BuiVanYen/DATN_START/Hardware/Dung dich/A_B/image.png

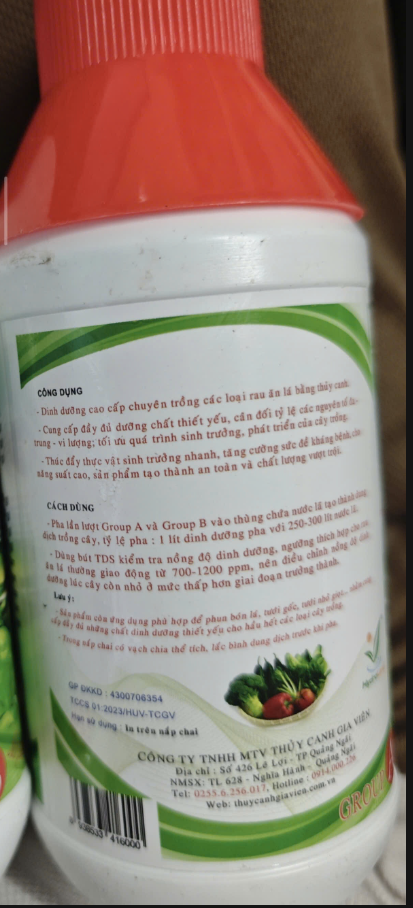
Hardware/Dung dich/A_B/image.png
