BuiVanYen/DATN_START/Hardware/Sensor_use/sht30/image1.png

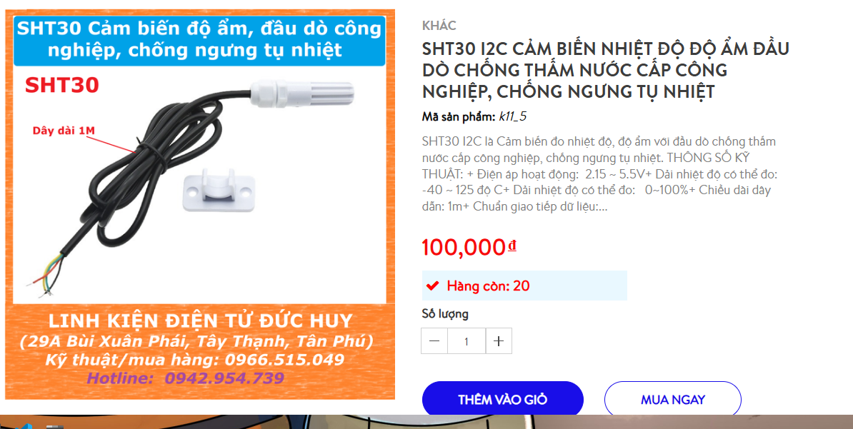
Hardware/Sensor_use/sht30/image1.png
