BuiVanYen/DATN_START/docs/Bao_Cao_Tien_Do/Bao_cao_He_thong_AIoT_Digital_Twin.pptx

BÁO CÁO ĐỒ ÁN TỐT NGHIỆP
ỨNG DỤNG AIoT TRỒNG XÀ LÁCH THỦY CANH NFT
VỚI CÔNG NGHỆ DIGITAL TWIN
Hệ thống giám sát, điều khiển thời gian thực kết hợp AI & Mô phỏng cơ điện tử 3D

Sinh viên thực hiện: [Tên Sinh Viên]
Giáo viên hướng dẫn: [Tên GVHD]
Chuyên ngành: Kỹ thuật Điều khiển & Tự động hóa

## Slide 2

GIỚI THIỆU CHUNG

Tổng Quan Đồ Án & Công Nghệ Lõi

Đồ án xây dựng một giải pháp nông nghiệp công nghệ cao toàn diện, tích hợp trí tuệ nhân tạo và mô phỏng 3D thời gian thực. Hệ thống được chia thành 3 mảng cốt lõi:

1. IoT & Phần Cứng
Trạm giám sát ESP32 thu thập các thông số pH, TDS, nhiệt độ, độ ẩm và mực nước bể.
Điều khiển chính xác cơ cấu chấp hành bằng tín hiệu PWM (quạt gió, bơm dinh dưỡng) và Relay (bơm chính, sục khí, LED Grow).

2. AI & FastAPI Backend
FastAPI làm trung tâm điều phối dữ liệu MQTT, lưu trữ InfluxDB, đồng bộ WebSocket.
Tích hợp mô hình học sâu CNN (MobileNetV2 TFLite) nhận diện bệnh lá và XGBoost Regressor dự báo sinh trưởng.

3. Digital Twin 3D
Mô hình hóa hệ thống 3D trên Siemens NX MCD (Mechatronics Concept Designer).
Đồng bộ hóa 2 chiều thực - ảo qua OPC UA, mô phỏng động học quạt, dòng chảy nước và quá trình lớn lên của cây.

## Slide 3

KIẾN TRÚC HỆ THỐNG

Sơ Đồ Khối Hệ Thống Tổng Thể

**Luồng dữ liệu thu thập & điều khiển:**
1. Trạm ESP32-S3 gửi dữ liệu cảm biến qua MQTT lên FastAPI.
2. FastAPI lưu dữ liệu chuỗi thời gian vào InfluxDB, đồng thời đẩy lên Web UI qua WebSocket.
3. FastAPI cập nhật dữ liệu cảm biến lên OPC UA Server.
4. Mô hình Siemens NX MCD kết nối OPC UA Server để đồng bộ hóa hoạt động ảo.
5. Ngược lại, lệnh điều khiển từ Web UI được FastAPI ghi vào OPC UA Server và gửi về ESP32 điều khiển thực tế.

ESP32-S3
(Cảm biến & Relay)

MQTT Broker
(Mosquitto)

Web UI
(Dashboard)

FastAPI Backend
(Bộ điều phối chính)

InfluxDB
(Time-Series)

OPC UA Server
(asyncua)

AI Modules
(CNN & XGBoost)

Siemens NX MCD
(Mô phỏng 3D)

## Slide 4

PHẦN 1
FASTAPI BACKEND - BỘ NÃO ĐIỀU PHỐI TRUNG TÂM
Xử lý dữ liệu, kiểm soát thiết bị, tích hợp trí tuệ nhân tạo và đồng bộ hóa thực - ảo

## Slide 5

PHẦN 1: FASTAPI BACKEND

FastAPI - Vai Trò Và Các Đầu Mục Công Việc

**1. Thu thập & Quản lý dữ liệu cảm biến:**
Lắng nghe luồng dữ liệu MQTT JSON từ ESP32.
Bóc tách các thông số: Nhiệt độ, độ ẩm, pH, TDS, mực nước.
Ghi đồng thời dữ liệu vào cơ sở dữ liệu chuỗi thời gian InfluxDB.
**2. Cung cấp API Điều khiển Thiết bị:**
Nhận lệnh điều khiển (xung PWM, trạng thái bật/tắt Relay) từ Web UI.
Chuyển tiếp tín hiệu điều khiển xuống ESP32 qua MQTT Broker.

**3. Tích hợp AI trực tiếp trên Backend:**
Endpoint tiếp nhận ảnh tải lên từ Web UI để chạy chẩn đoán bệnh lá (CNN MobileNetV2 - TFLite Interpreter).
Chạy mô hình hồi quy (XGBoost Regressor) định kỳ để dự báo tiến độ sinh trưởng cây.
**4. Đồng bộ hóa thời gian thực (Real-time Link):**
Thiết lập WebSocket Server để đẩy tức thời dữ liệu cảm biến mới lên Web UI.
Kết nối trực tiếp và ghi dữ liệu lên OPC UA Server để đồng bộ hóa trạng thái với mô hình Siemens NX MCD 3D.

## Slide 6

PHẦN 1: FASTAPI BACKEND

Hệ Thống REST API & Kết Nối Đồng Bộ

API Điều khiển Thiết bị (Control)
POST /api/control/pwm: Điều chỉnh tốc độ quạt thông gió (0-255) và 3 bơm châm dinh dưỡng nhu động.
POST /api/control/relay: Bật/tắt bơm chính 220V, máy sục khí oxy bể chứa và 4 cụm đèn LED Grow.

Cơ Chế Đồng Bộ Hóa Dữ Liệu
**Kết nối WebSocket:**
- Tạo kết nối song song, giữ trạng thái liên tục giữa FastAPI và Web UI.
- Cảm biến cập nhật mỗi 30s được đẩy ngay lập tức mà không cần tải lại trang.
**Kết nối OPC UA Bridge:**
- Tích hợp client kết nối vào Python OPC UA Server.
- Tự động đồng bộ các Node: Trạng thái quạt quay, bơm chảy, đèn sáng, mực nước bể sang phần mềm mô phỏng 3D Siemens NX MCD.
- Đảm bảo độ trễ truyền thông < 100ms cho việc giám sát ảo.

API Dữ liệu & AI (Data & AI)
GET /api/sensor-data/latest: Lấy các thông số cảm biến mới nhất.
POST /api/ai/disease-detect: Nhận file ảnh từ camera để suy diễn bệnh.
GET /api/ai/growth-predict: Chạy định kỳ, dự báo % lớn và số ngày thu hoạch.

## Slide 7

PHẦN 2
INFLUXDB TIME-SERIES & GIAO DIỆN WEB UI
Lưu trữ dữ liệu chuỗi thời gian hiệu năng cao và Dashboard giám sát trực quan hóa 2D/AI

## Slide 8

PHẦN 2: CƠ SỞ DỮ LIỆU

Cấu Trúc Cơ Sở Dữ Liệu InfluxDB (Schema Design)

**Tại sao chọn InfluxDB?**
Tối ưu hóa ghi dữ liệu tần suất cao liên tục với mốc thời gian (timestamp).
Hiệu năng vượt trội so với SQL truyền thống đối với ứng dụng giám sát IoT.
Hỗ trợ ngôn ngữ truy vấn Flux mạnh mẽ để tính toán trung bình, lọc nhiễu dữ liệu.

Measurement: sensor_data
Lưu trữ dữ liệu môi trường từ các cảm biến.
**Fields (Dữ liệu số):**
- air_temp (nhiệt độ khí)
- air_humidity (độ ẩm khí)
- water_temp (nhiệt độ nước)
- tds (nồng độ dinh dưỡng)
- ph (độ kiềm/axit)
- light_intensity (cường độ sáng)
**Tags (Chỉ mục tìm kiếm):**
- device_id="esp32_01"
- location="nft_rack_1"

Measurement: actuator_status
Ghi lịch sử bật/tắt thiết bị để giám sát điện năng và vận hành.
**Fields (Số/Logic):**
- fan_1..4_pwm (tốc độ quạt)
- pump_dd_1..2_pwm (bơm dinh dưỡng)
- pump_220v (trạng thái bơm chính)
- grow_light_1..4 (trạng thái LED)
**Tags:**
- device_id="esp32_01"

Measurement: ai_predictions
Lưu vết lịch sử phân tích và suy diễn từ các thuật toán AI.
**Fields (Chuỗi/Số):**
- disease_label (tên loại bệnh)
- confidence (độ tin cậy %)
- growth_percent (% lớn của rau)
- days_remaining (ngày thu hoạch dự kiến)
**Tags:**
- model_version="v1.0"

## Slide 9

PHẦN 2: CƠ SỞ DỮ LIỆU

Vận Hành & Tối Ưu Hóa Dữ Liệu InfluxDB

**1. Cơ chế ghi dữ liệu bất đồng bộ (Async Data Ingestion):**
Trạm ESP32-S3 gửi gói tin JSON lên MQTT Broker mỗi 30 giây.
FastAPI Backend đón nhận bản tin, đóng gói thành đối tượng Point và sử dụng thư viện `influxdb-client-python` ghi bất đồng bộ (async write) vào InfluxDB.
Việc ghi bất đồng bộ giúp API chính không bị nghẽn (non-blocking) khi có nhiều kết nối đồng thời.
**2. Tính ổn định và khả năng phục hồi (High Availability & Reliability):**
Trên Raspberry Pi 4, InfluxDB được cấu hình hoạt động như một **Systemd Service** khởi động cùng hệ điều hành.
Thiết lập chính sách ghi đệm trên RAM và tự động khôi phục dữ liệu khi mất nguồn đột ngột, đảm bảo tính toàn vẹn dữ liệu lịch sử.
**3. Tối ưu hóa lưu trữ (Retention Policies):**
Do Raspberry Pi 4 sử dụng thẻ nhớ dung lượng giới hạn, InfluxDB được cấu hình **Retention Policy** tự động xóa dữ liệu thô cũ sau 30 ngày.
Trước khi xóa, dữ liệu được gom cụm (Downsampling) tính trung bình theo giờ để lưu trữ dài hạn hơn, tránh làm đầy bộ nhớ thẻ nhớ.

## Slide 10

PHẦN 2: WEB UI DASHBOARD

Giao Diện Web UI Dashboard & Điều Khiển Thiết Bị

**Bảng điều khiển trung tâm (Dashboard):**
Hiển thị trực quan các chỉ số cảm biến theo thời gian thực (nhiệt độ, độ ẩm, pH, TDS).
Trạng thái thiết bị hiển thị trực quan thông qua các màu sắc và hiệu ứng chỉ báo động.
**Cơ chế điều khiển thiết bị ngoại vi:**
**Thanh trượt (Slider):** Điều khiển xung PWM từ 0 đến 255 để tăng giảm tốc độ quạt thông gió và lưu lượng bơm châm dinh dưỡng.
**Nút gạt (Toggle Switch):** Điều khiển rơ-le bật/tắt bơm tuần hoàn chính, sục khí, và đèn LED Grow.
Mỗi thao tác của người dùng sẽ kích hoạt ngay một request POST tới endpoint điều khiển tương ứng trên FastAPI.

**Tích hợp biểu đồ phân tích lịch sử (Chart.js):**
Nhúng thư viện biểu đồ JavaScript gọn nhẹ `Chart.js`.
Cho phép người dùng theo dõi biểu đồ đường diễn biến thông số pH, TDS, và nhiệt độ bể chứa trong 24 giờ qua hoặc theo tuần.
Giúp phát hiện sớm sự biến động bất thường của dinh dưỡng để can thiệp kịp thời.
**Đồng bộ giao diện thời gian thực:**
Web UI duy trì kết nối WebSocket liên tục tới FastAPI.
Dữ liệu cảm biến mới tự động cập nhật lên giao diện mà không cần người dùng tải lại trang (F5), mang lại trải nghiệm mượt mà.

## Slide 11

PHẦN 2: WEB UI DASHBOARD

Mô Phỏng 2D & Chẩn Đoán Bệnh Lá Qua Camera

**Mô phỏng Digital Twin dạng 2D trực quan:**
Sử dụng đồ họa Canvas/SVG động để phác họa sơ đồ giàn NFT.
**Cơ chế hoạt động động (Dynamic UI animation):**
- Khi quạt thông gió được bật ở thực tế (hoặc mô phỏng), hình ảnh cánh quạt tương ứng trên Web UI sẽ xoay với tốc độ tỷ lệ thuận.
- Khi máy bơm chính hoạt động, đường dẫn ống nước ảo trên màn hình sẽ tạo hiệu ứng dòng hạt chảy chuyển động.
- Đèn LED Grow chuyển từ xám tối sang màu sáng hồng khi ở trạng thái hoạt động.
Giúp người vận hành nhanh chóng nhận biết trạng thái vật lý của hệ thống chỉ với một cái nhìn lướt qua.

**Tích hợp Camera điện thoại để chẩn đoán bệnh:**
Web UI tận dụng thuộc tính HTML5 `capture="camera"` trong thẻ tải ảnh.
Khi người vận hành mở giao diện trên điện thoại và bấm "Chụp ảnh lá", trình duyệt sẽ tự động kích hoạt camera điện thoại để chụp cận cảnh chiếc lá nghi bị bệnh.
Ảnh chụp được đóng gói dạng `Multipart/form-data` và gửi lên API của FastAPI.
Kết quả chẩn đoán bệnh và độ tin cậy (%) từ mô hình AI được trả về và hiển thị ngay lập tức lên màn hình, đồng thời lưu lịch sử.

## Slide 12

PHẦN 3
OPC UA SERVER - CẦU NỐI ĐỒNG BỘ THỜI GIAN THỰC
Giao thức truyền thông công nghiệp kết nối logic điều khiển với mô hình cơ điện tử 3D

## Slide 13

PHẦN 3: OPC UA SERVER

Nguyên Lý Hoạt Động & Vai Trò Của OPC UA Server

**Tổng quan về giao thức OPC UA:**
Là tiêu chuẩn truyền thông công nghiệp thế hệ mới, độc lập hệ điều hành, bảo mật và tin cậy cao.
Đóng vai trò là "bộ nhớ chia sẻ" hay ngôn ngữ chung kết nối giữa hệ thống phần mềm (FastAPI, Web) và phần phần mềm mô phỏng (Siemens NX MCD).
**Nguyên lý hoạt động Client - Server:**
**OPC UA Server (Trung tâm):** Được triển khai bằng thư viện Python `asyncua` chạy trên Pi hoặc PC giả lập, lắng nghe tại cổng `4840`.
Tạo ra một không gian địa chỉ (Address Space) phân tầng chứa các điểm dữ liệu đại diện cho cảm biến và cơ cấu chấp hành.

**Các Client kết nối tương tác:**
**FastAPI (Client 1):** Khi nhận dữ liệu cảm biến mới từ thực tế, FastAPI ghi giá trị vào các Node cảm biến trên OPC UA Server. Khi nhận lệnh từ Web UI, FastAPI ghi vào các Node thiết bị.
**Siemens NX MCD (Client 2):** Kết nối vào OPC UA Server, liên tục đọc trạng thái các Node thiết bị (quạt, bơm) để kích hoạt chuyển động cơ điện tử 3D tương ứng.
**Python Simulator (Client 3 - Chế độ SIL):** Đọc lệnh điều khiển, mô phỏng phản hồi vật lý (ví dụ: bật quạt làm giảm nhiệt độ ảo), ghi ngược thông số ảo vào các Node cảm biến.

## Slide 14

PHẦN 3: OPC UA SERVER

Sơ Đồ Luồng Truyền Thông Software-in-the-Loop

**Luồng trao đổi tín hiệu hai chiều (Real-time Sync):**
Giao diện Web UI gửi lệnh điều khiển -> FastAPI nhận lệnh -> Ghi lệnh vào OPC UA Server.
Siemens NX MCD 3D liên tục đọc lệnh từ OPC UA Server -> Chạy hoạt cảnh chuyển động 3D tương ứng.
Cảm biến ảo trong NX MCD (ví dụ va chạm nước đầy) -> Ghi True vào Node cảm biến trên OPC UA Server.
FastAPI Backend nhận thay đổi từ OPC UA Server -> Đẩy tin nhắn WebSocket báo đèn đỏ lên Web UI.

Web App
(Giao diện điều khiển)

FastAPI Backend
(Điều hướng tín hiệu)

OPC UA Server
(asyncua - Port 4840)

Siemens NX MCD
(Mô phỏng 3D)

**[Chiều 1: Điều khiển]** Web UI (PWM/Relay) ----> FastAPI ----> OPC UA Node ----> NX MCD (Hoạt cảnh khớp quay/đèn sáng)
**[Chiều 2: Phản hồi cảm biến]** NX MCD (Va chạm nước/Scale cây) ----> OPC UA Node ----> FastAPI ----> Web UI (Đèn báo động/Biểu đồ)

## Slide 15

PHẦN 3: OPC UA SERVER

Chi Tiết Thiết Kế Cấu Trúc Nodes Trên Server

Để các Client thực và ảo hiểu nhau, không gian địa chỉ trên OPC UA Server được quy hoạch đồng nhất bằng các Node ID có cấu trúc rõ ràng:

Thư mục: Cảm biến (Sensors)
Lưu trữ dữ liệu đo lường môi trường từ ESP32 hoặc bộ Simulator.
**Các Node ID chính:**
- `ns=2;s=sensor.temp` (Float)
*Nhiệt độ không khí ảo*
- `ns=2;s=sensor.ph` (Float)
*Độ pH nước bể chứa*
- `ns=2;s=sensor.water_level_1..4`
(Boolean)
*Trạng thái 4 mức nước ảo*

Thư mục: Thiết bị (Actuators)
Chứa trạng thái hoạt động và công suất điều khiển thiết bị.
**Các Node ID chính:**
- `ns=2;s=actuator.fan_1..4` (Int)
*Tốc độ quạt gió (0-255)*
- `ns=2;s=actuator.pump_dd_1..2` (Int)
*Bơm dinh dưỡng PWM*
- `ns=2;s=actuator.pump_220v` (Boolean)
*Trạng thái bơm chính*
- `ns=2;s=actuator.grow_light_1..4`
(Boolean)
*Trạng thái bật/tắt LED*

Thư mục: AI (Predictions)
Lưu trữ kết quả dự báo sinh trưởng của cây từ mô hình XGBoost.
**Các Node ID chính:**
- `ns=2;s=ai.growth_percent` (Float)
*Tiến trình sinh trưởng (0.0% - 100.0%)*
- `ns=2;s=ai.days_remaining` (Float)
*Số ngày dự kiến đến kỳ thu hoạch*
- Các Node này được sử dụng để điều khiển tham số Scale cây trong NX MCD.

## Slide 16

PHẦN 4
TRÍ TUỆ NHÂN TẠO - CNN & XGBOOST
Mô hình học sâu chẩn đoán bệnh lá CNN MobileNetV2 và thuật toán XGBoost dự báo sinh trưởng cây

## Slide 17

PHẦN 4: TRÍ TUỆ NHÂN TẠO

Mô Hình Học Sâu CNN Chẩn Đoán Bệnh Lá

**Tổng quan mô hình CNN MobileNetV2:**
MobileNetV2 là kiến trúc mạng nơ-ron tích chập được cải tiến của Google, thiết kế tối ưu cho thiết bị nhúng nhờ cơ chế tích chập tách kênh chiều sâu (Depthwise Separable Convolution).
Giúp giảm thiểu tối đa số lượng tham số tính toán và dung lượng mô hình, duy trì độ chính xác cao.
**Quy trình chuẩn bị và huấn luyện (Google Colab):**
**Thu thập Dataset:** Xây dựng tập ảnh mẫu khoảng 500-1000 ảnh cho mỗi lớp bệnh gồm: *Healthy* (Lá khỏe), *Leaf Spot* (Đốm lá), *Downy Mildew* (Sương mai), và *Nutrient Deficiency* (Thiếu dinh dưỡng).
**Huấn luyện (Transfer Learning):** Sử dụng Base Model MobileNetV2 đã huấn luyện sẵn trên tập ImageNet, đóng băng các lớp đầu và huấn luyện lại lớp phân loại cuối (Fine-tuning) bằng Keras/TensorFlow.

**Tối ưu hóa và chuyển đổi sang TensorFlow Lite:**
Mô hình ban đầu sau huấn luyện có kích thước rất lớn (~50MB - 100MB), gây quá tải và trễ lớn khi chạy trực tiếp trên CPU của Raspberry Pi 4.
Sử dụng công cụ `TFLiteConverter` để thực hiện lượng tử hóa (Quantization) mô hình từ dạng số thực dấu phẩy động 32-bit sang số nguyên 8-bit (INT8).
Kích thước mô hình giảm xuống **dưới 10MB**, tăng tốc độ suy diễn (inference) lên nhiều lần mà sai lệch độ chính xác không đáng kể.
**Triển khai trên FastAPI:**
Viết module Python nạp trực tiếp file `.tflite` bằng thư viện `tf.lite.Interpreter`.
Thực hiện chẩn đoán bất đồng bộ khi nhận ảnh tải lên từ Web UI.

## Slide 18

PHẦN 4: TRÍ TUỆ NHÂN TẠO

Luồng Xử Lý Suy Diễn Ảnh Của CNN TFLite

**Luồng xử lý từ ảnh chụp camera đến kết quả chẩn đoán:**
1. Người vận hành chụp ảnh lá bệnh bằng điện thoại -> Tải lên qua Web UI gửi tới API `/api/ai/disease-detect`.
2. Bộ tiền xử lý (Preprocessing) trên FastAPI chuyển đổi ảnh về định dạng ma trận $224 \times 224 \times 3$, chuẩn hóa giá trị pixel về đoạn $[0, 1]$ hoặc $[-1, 1]$.
3. Ma trận ảnh được đưa vào `tf.lite.Interpreter` để chạy suy diễn mạng nơ-ron.
4. Lớp Softmax cuối cùng phân loại và trả ra xác suất tin cậy của các loại bệnh tương ứng.
5. Trả về kết quả dạng JSON lên Web UI để hiển thị cho người dùng, đồng thời lưu lịch sử chẩn đoán vào InfluxDB.

Camera Điện Thoại
(Chụp lá bệnh)

Tiền Xử Lý Ảnh
(Resize 224x224)

TFLite Interpreter
(Chạy suy diễn CNN)

Phân Loại Bệnh
(Lớp Softmax)

Kết Quả JSON
(Hiển thị & Lưu)

**[Dữ liệu đầu ra JSON mẫu]**:
`{"status": "success", "disease": "Leaf Spot", "confidence": 94.2, "timestamp": "2026-06-12T15:56:00Z"}`

## Slide 19

PHẦN 4: TRÍ TUỆ NHÂN TẠO

Mô Hình XGBoost Dự Báo Sinh Trưởng & Ngày Thu Hoạch

**Giới thiệu thuật toán XGBoost (Extreme Gradient Boosting):**
Là thuật toán học máy nâng cao dựa trên cấu trúc cây quyết định (Decision Trees), sử dụng kỹ thuật học tăng cường gradient để tối ưu hóa sai số và tốc độ tính toán.
Được áp dụng dưới dạng mô hình hồi quy (Regression) để dự báo phần trăm sinh trưởng (`growth_percent`) và số ngày còn lại đến kỳ thu hoạch (`days_remaining`).
**Nguyên lý sửa sai bằng Gradient (Gradient Boosting):**
Không tạo một cây quyết định đơn lẻ phức tạp dễ bị quá khớp (overfitting).
Xây dựng tuần tự chuỗi các cây quyết định đơn giản (weak learners). Cây thứ hai được huấn luyện để sửa sai số (residuals) của cây thứ nhất, cây thứ ba sửa sai cho cây thứ hai, cứ thế tiếp diễn.
Kết quả dự báo cuối cùng là tổng cộng dồn dự đoán từ tất cả các cây quyết định nhân với hệ số học tập (Learning Rate).

**Các biến đầu vào (Features) của mô hình:**
`cumulative_days` (Tuổi cây): Số ngày kể từ khi trồng lên máng NFT.
`mean_temp` (Nhiệt độ trung bình): Nhiệt độ không khí trung bình trong ngày.
`daily_light_integral` (DLI - Tích lũy ánh sáng): Tổng lượng ánh sáng tích lũy mà cây nhận được mỗi ngày (đo từ cảm biến BH1750).
`average_tds` (TDS trung bình): Nồng độ chất dinh dưỡng trung bình trong nước bể chứa.
`average_ph` (pH trung bình): Chỉ số pH trung bình của nước.
**Các biến đầu ra (Targets):**
`growth_percent` (0.0% đến 100.0%): Tiến độ lớn lên của cây.
`days_remaining` (ví dụ từ 30 ngày đếm ước về 0): Ước tính số ngày còn lại đến thời điểm thu hoạch tối ưu.

## Slide 20

PHẦN 4: TRÍ TUỆ NHÂN TẠO

Vận Hành Dự Báo & Đồng Bộ Kích Thước Cây 3D

**Chu kỳ vận hành của mô hình XGBoost trong hệ thống:**
1. Hằng ngày, FastAPI tự động truy xuất dữ liệu lịch sử tích lũy từ InfluxDB và trích xuất các đặc trưng đầu vào (DLI, TDS trung bình, pH trung bình, nhiệt độ).
2. FastAPI gọi mô hình XGBoost Regressor đã được đóng gói để thực hiện dự báo.
3. Kết quả dự báo được ghi trực tiếp vào các Node tương ứng trên OPC UA Server: `ai.growth_percent` và `ai.days_remaining`.
4. Phần mềm Siemens NX MCD 3D liên tục đọc Node `ai.growth_percent` và gắn trực tiếp giá trị này vào tham số tỷ lệ hình học (**Scale Factor**) của cụm lettuce 3D.
5. Nhờ đó, mô hình cây 3D trên màn hình máy tính tự động phóng to dần từ 0% đến 100% tương thích với sự phát triển thực tế của cây rau.

Dữ Liệu InfluxDB
(Thông số môi trường)

Trích Xuất Đặc Trưng
(Tính DLI, pH, TDS)

Mô Hình XGBoost
(Dự báo sinh trưởng)

Node OPC UA
(ai.growth_percent)

Siemens NX MCD
(Scale cây 3D)

**[Lợi ích của phương pháp này]**:
Trực quan hóa tiến trình sinh trưởng được hỗ trợ bởi trí tuệ nhân tạo một cách sinh động.
Cho phép người vận hành nhìn thấy trước kết quả phát triển ảo trước khi đưa ra quyết định thu hoạch thực tế.

## Slide 21

PHẦN 5
DIGITAL TWIN 3D - SIEMENS NX MCD
Mô phỏng động học cơ điện tử, tương tác vật lý dòng chảy chất lỏng và cảm biến tiệm cận ảo

## Slide 22

PHẦN 5: DIGITAL TWIN 3D

Mô Hình Hóa Bản Sao Số Trên Siemens NX MCD

**Tổng quan về Siemens NX MCD:**
Mechatronics Concept Designer (MCD) cung cấp môi trường mô phỏng vật lý đa ngành (cơ khí, điện, điều khiển).
Cho phép biến các mô hình 3D tĩnh (CAD) thành các đối tượng có tính chất vật lý thực tế, có khớp chuyển động, trọng lực và tương tác va chạm.
**Quy trình xây dựng mô hình ảo:**
**Thiết kế CAD 3D:** Thiết kế mô hình tỷ lệ hình học 1:1 của khung thép giàn thủy canh, máng NFT, bể chứa dung dịch dinh dưỡng, quạt thông gió, phao cơ học, đèn LED Grow và cây xà lách.
**MCD Physics Configuration:** Khai báo các đối tượng cứng (Rigid Body) để gán khối lượng, trọng lực, ma sát cho quạt, máng, phao.

**Thiết lập các khớp động học (Joints & Motion):**
Gán khớp xoay (Hinged Joint) cho các cánh quạt thông gió.
Gán khớp tịnh tiến dọc (Prismatic Joint) cho phao đo mực nước trong bể chứa.
**Kết nối truyền thông (External Signal Configuration):**
Định cấu hình kết nối OPC UA Client tích hợp trong NX MCD.
Thực hiện ánh xạ tín hiệu (Signal Mapping): Liên kết các tham số điều khiển ảo (khớp quay, khớp tịnh tiến, tính chất vật liệu) với các Node ID tương ứng trên OPC UA Server.
Chạy mô hình ở chế độ kiểm thử vòng lặp phần mềm (Software-in-the-Loop - SIL) để kiểm tra tính đúng đắn của giải thuật điều khiển trước khi đấu nối phần cứng thật.

## Slide 23

PHẦN 5: DIGITAL TWIN 3D

Mô Phỏng Cơ Cấu Chấp Hành Ảo Trong NX MCD

**1. Mô phỏng động học quạt thông gió:**
Khớp xoay (Hinged Joint) của cánh quạt được gán cơ chế điều khiển tốc độ (Speed Control).
Khi nhận giá trị xung PWM (0-255) từ Node ID tương ứng qua OPC UA, hệ thống sẽ nhân với hệ số quy đổi để gán vận tốc quay ảo (vòng/phút).
Người vận hành quan sát thấy cánh quạt 3D quay nhanh, chậm tương ứng với thao tác kéo thanh trượt trên Web UI.
**2. Mô phỏng ánh sáng đèn LED Grow:**
Gán thuộc tính vật liệu phát quang (Emission/Luminance) cho các cụm đèn LED Grow 3D.
Khi nhận tín hiệu Relay ON (True) từ OPC UA Server, vật liệu của đèn tự động thay đổi từ màu xám tối sang màu sáng hồng/đỏ rực rỡ, biểu thị đèn đang hoạt động chiếu sáng bổ sung quang phổ cho cây rau.

**3. Mô phỏng máy bơm & dòng chảy dinh dưỡng:**
Sử dụng tính năng tạo hạt vật lý (Liquid/Particle Path) trong NX MCD để giả lập dòng nước chảy.
Khi bơm tuần hoàn chính ở trạng thái ON, vòi cấp nước sẽ phun ra liên tục các hạt chất lỏng ảo chịu tác động của trọng lực.
Các hạt nước ảo tự động chảy dọc theo độ dốc của máng NFT, bao quanh rễ cây ảo và chảy dồn về ống thoát để rơi ngược lại bể chứa.
Lưu lượng nước ảo phun ra (tần suất sinh hạt) được lập trình tỷ lệ thuận với xung điều khiển PWM của bơm châm dinh dưỡng nhận từ OPC UA Server.

## Slide 24

PHẦN 5: DIGITAL TWIN 3D

Mô Phỏng Mực Nước & Cảm Biến Tiệm Cận Ảo

**Mô phỏng cơ chế phao đo nước cơ học:**
Một phao nhựa 3D được thiết kế đặt trong bể chứa dung dịch dinh dưỡng.
Phao được gán khớp tịnh tiến đứng (Prismatic Joint) và có lực đẩy nổi ảo khi các hạt chất lỏng dâng lên.
Khi mức nước (hạt chất lỏng) dâng cao, phao cơ học tự động trượt lên trên dọc theo trục Prismatic Joint.
**Mô phỏng cảm biến tiệm cận ảo (Giả lập cảm biến Y26):**
Đặt 4 cảm biến va chạm ảo (Collision Sensor) tương ứng với 4 cao độ nước đầy/cạn khác nhau trong bể chứa ảo.
Các cảm biến va chạm này hoạt động bằng cách phát hiện sự giao thoa không gian hình học (Collision) với phao nhựa ảo hoặc với các hạt chất lỏng dâng lên.

**Cơ chế truyền tín hiệu phản hồi ngược:**
Khi phao nhựa ảo dâng lên và chạm vào Collision Sensor thứ 4 (mốc nước đầy):
- 1. Collision Sensor 3D kích hoạt trạng thái logic True.
- 2. NX MCD ngay lập tức ghi giá trị True vào Node ID `ns=2;s=sensor.water_level_4` trên OPC UA Server.
- 3. FastAPI Backend đang lắng nghe OPC UA Server phát hiện sự thay đổi này.
- 4. FastAPI bóc tách dữ liệu và đẩy bản tin qua WebSocket tới Web UI.
- 5. Web UI lập tức nhấp nháy đèn cảnh báo đỏ và hiển thị trạng thái "Bể nước đầy" trên Dashboard.
Thể hiện sự khép kín của vòng lặp điều khiển và giám sát thực - ảo hai chiều.

## Slide 25

TỔNG KẾT

Kết Luận & Hướng Phát Triển Đề Tài

**Các kết quả đạt được của đồ án:**
**Thiết kế hệ thống SIL (Software-in-the-Loop) hoàn chỉnh:** Cho phép thử nghiệm, tối ưu hóa các thuật toán điều khiển và chẩn đoán AI mà không cần lắp đặt phần cứng thực tế, giảm thiểu rủi ro hỏng hóc và chi phí thử nghiệm.
**Hệ thống Backend & Database mạnh mẽ:** FastAPI điều phối dữ liệu với độ trễ thấp (< 100ms), InfluxDB lưu trữ dữ liệu chuỗi thời gian tối ưu hóa dung lượng thẻ nhớ cho Pi.
**Tích hợp mô hình AI thực tế:** CNN MobileNetV2 lượng tử hóa chạy mượt mà dưới 10MB trên Pi cho kết quả chẩn đoán nhanh. XGBoost dự báo chính xác ngày thu hoạch.
**Bản sao số 3D sinh động:** Siemens NX MCD mô phỏng chân thực động học, chất lỏng và scale kích thước cây theo AI.

**Hướng phát triển tiếp theo:**
**Đấu nối phần cứng thật (Hardware-in-the-Loop - HIL):** Thiết lập và chế tạo mạch PCB ESP32-S3 thực tế để thu thập dữ liệu cảm biến thực và điều khiển các thiết bị thật (quạt, bơm, LED thật).
**Hiệu chuẩn mô hình AI (Calibration):** Tiếp tục thu thập thêm ảnh lá bệnh thực tế tại vườn để tăng cường độ chính xác cho mô hình CNN. Thu thập dữ liệu thực tế nhiều vụ trồng xà lách để hiệu chỉnh mô hình XGBoost.
**Mở rộng mô phỏng vật lý:** Mô phỏng nâng cao ảnh hưởng của lưu lượng gió từ quạt đến sự giảm nhiệt độ và độ ẩm ảo trong NX MCD bằng cách kết hợp giải thuật CFD (Computational Fluid Dynamics) đơn giản hóa.
