BuiVanYen/DATN_START/Hardware/BanVeCK_Yen/machcontrol.jpg

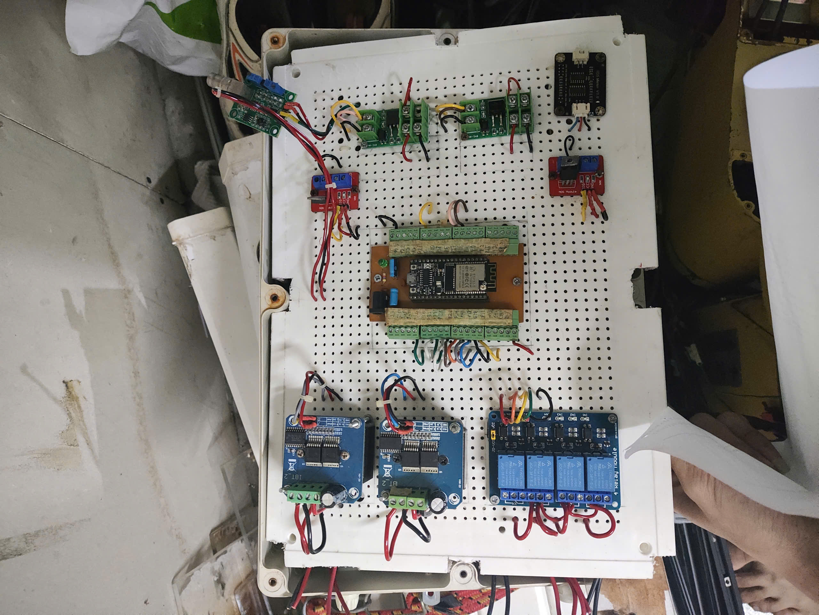
Hardware/BanVeCK_Yen/machcontrol.jpg
