BuiVanYen/DATN_START/Hardware/BanVeCK_Yen/mau.jpg

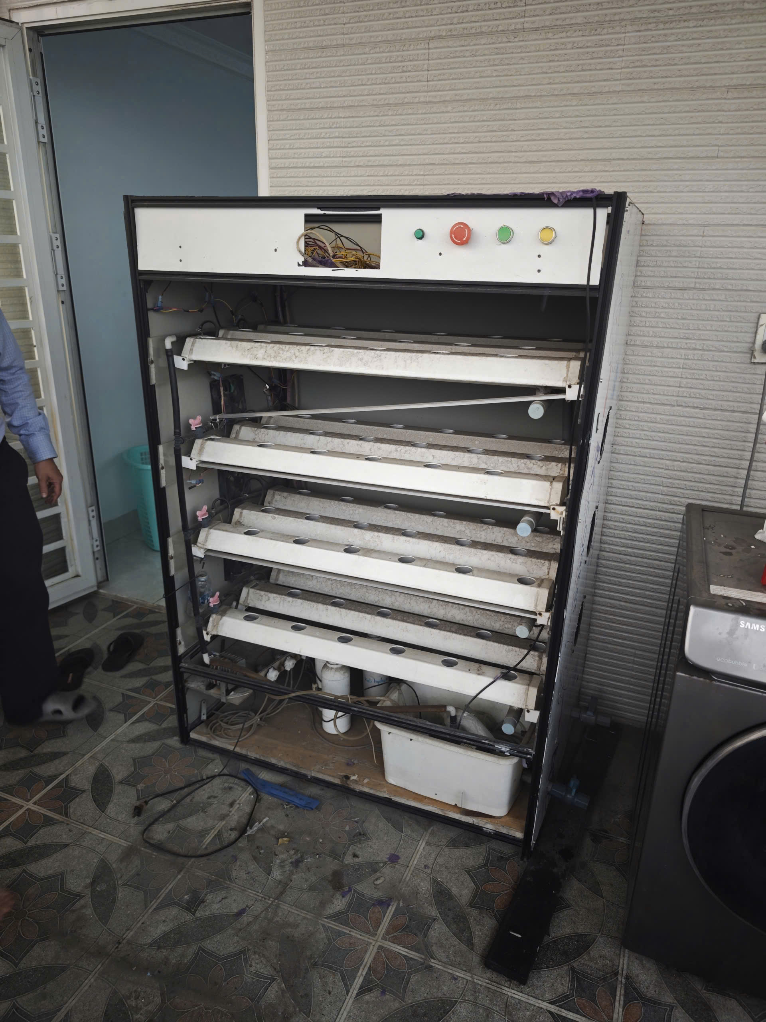
Hardware/BanVeCK_Yen/mau.jpg
