BuiVanYen/DATN_START/Hardware/Dung dich/A_B/image1.png

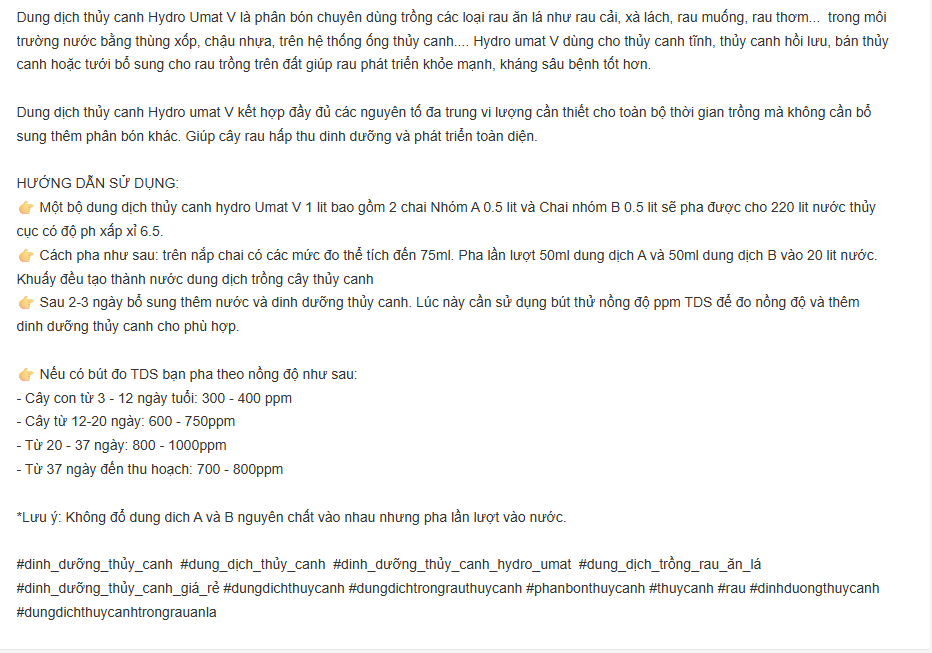
Hardware/Dung dich/A_B/image1.png
