BuiVanYen/DATN_START/Hardware/Dung dich/Ph down/image.png

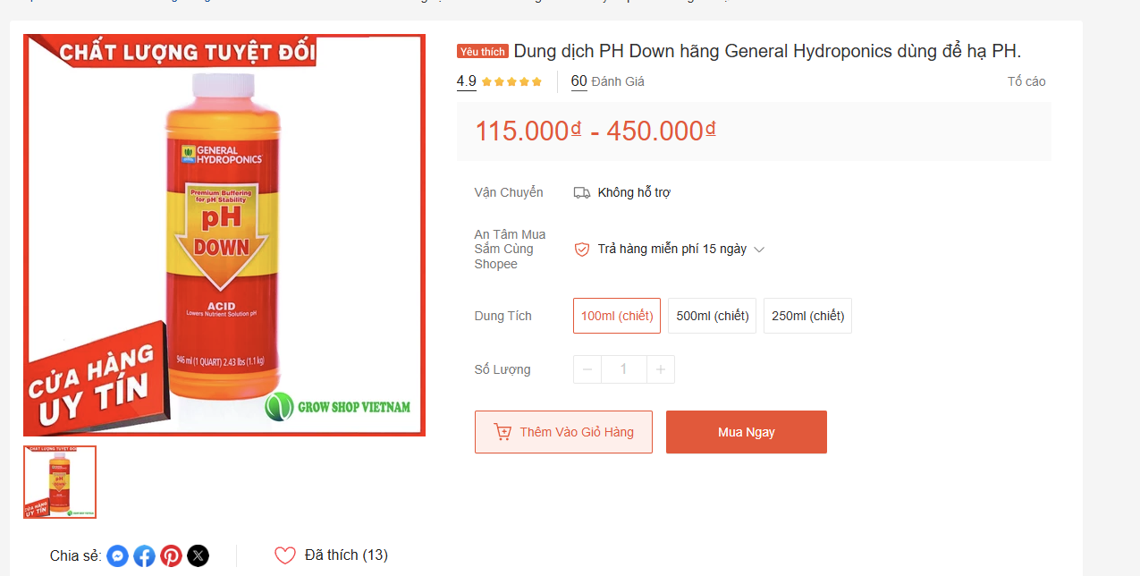
Hardware/Dung dich/Ph down/image.png
