BuiVanYen/DATN_START/Hardware/PCB_Design/schematic_ver2_page1.png

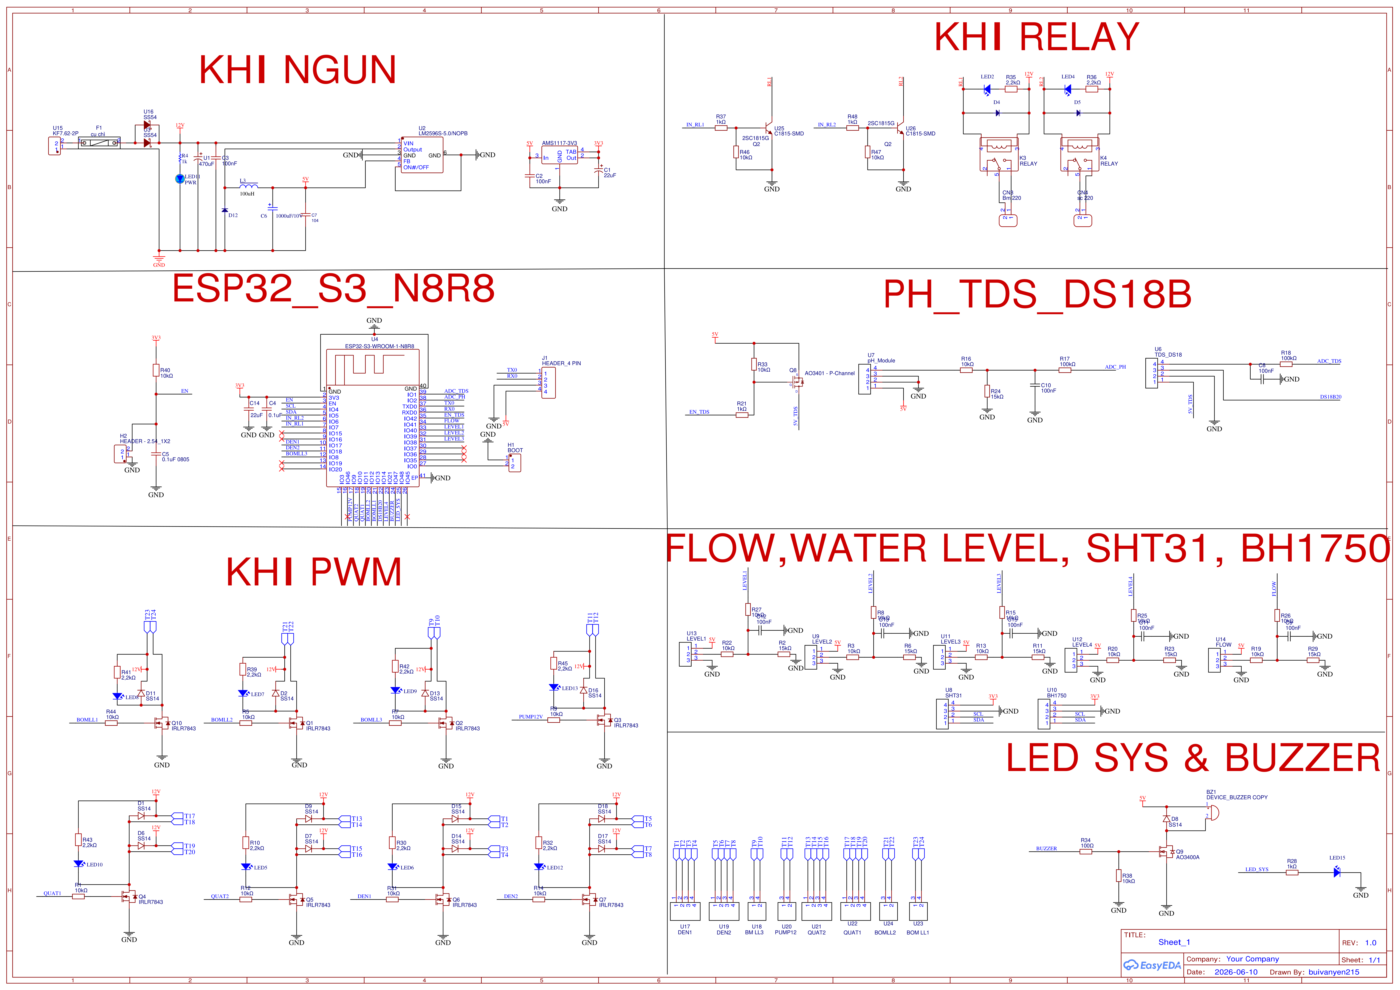
Hardware/PCB_Design/schematic_ver2_page1.png
