BuiVanYen/DATN_START/Hardware/Sensor_use/bh1750/image.png

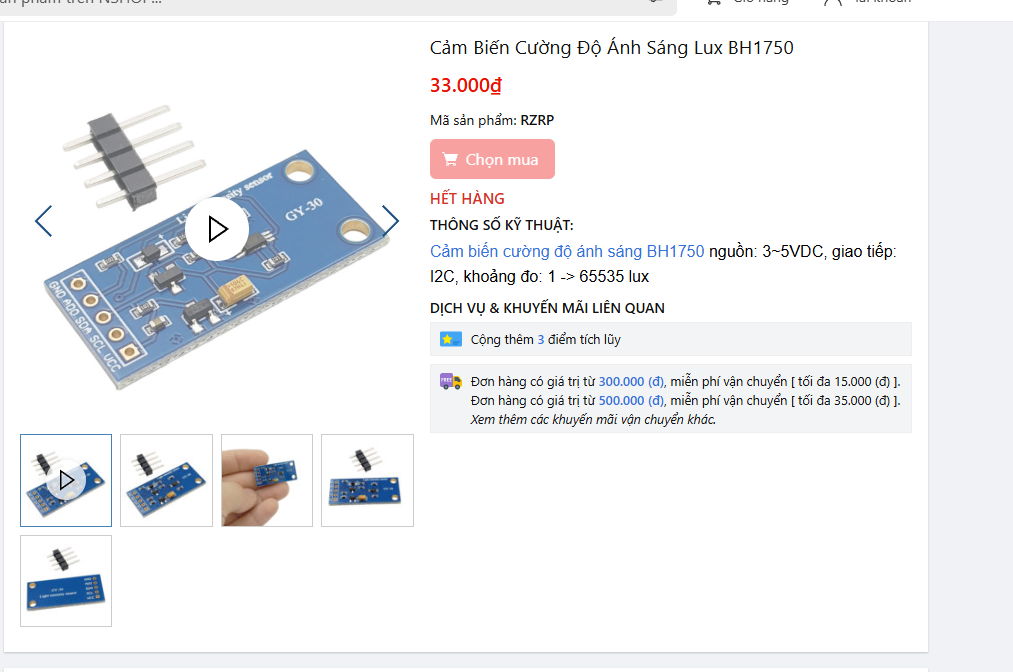
Hardware/Sensor_use/bh1750/image.png
