BuiVanYen/DATN_START/Hardware/Sensor_use/Flow/image1.png

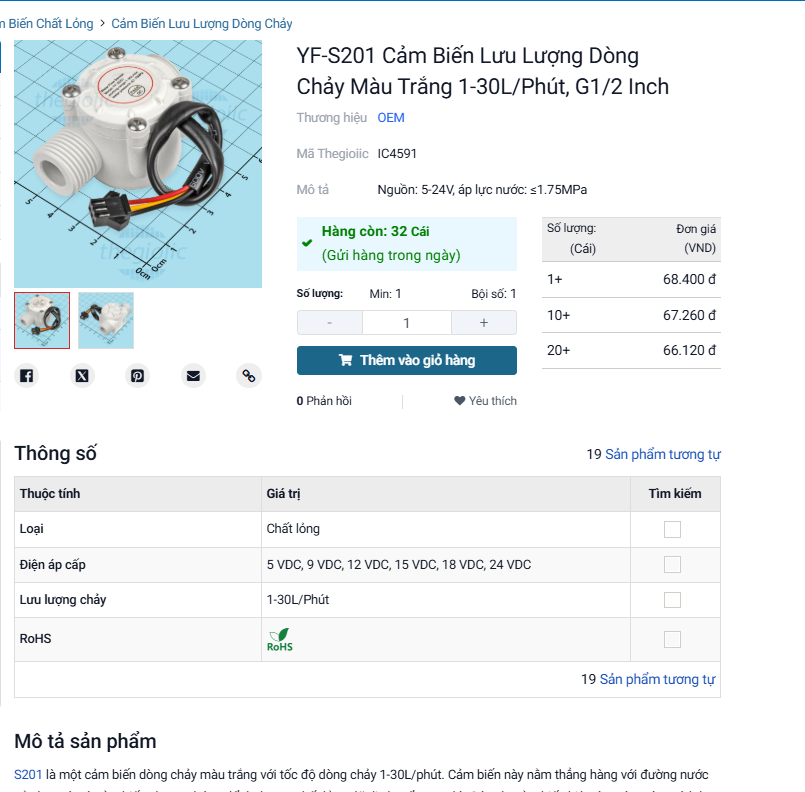
Hardware/Sensor_use/Flow/image1.png
