BuiVanYen/DATN_START/Hardware/Sensor_use/Flow/image.png

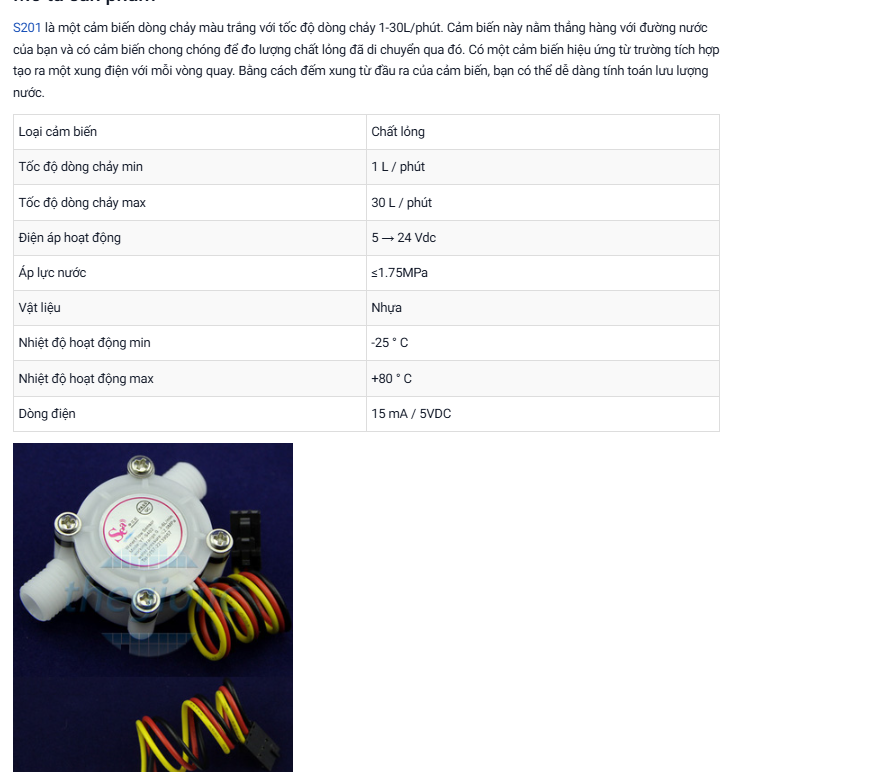
Hardware/Sensor_use/Flow/image.png
