BuiVanYen/DATN_START/Hardware/Sensor_use/muc_nuoc/3.jpg

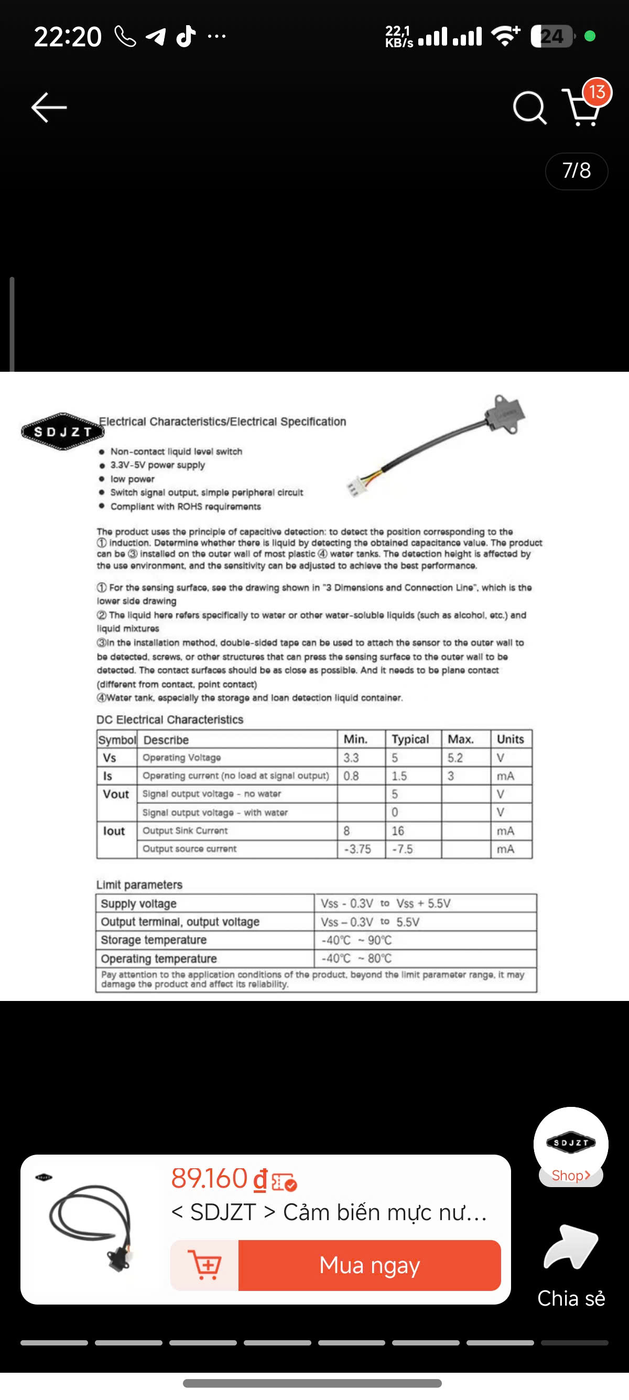
Hardware/Sensor_use/muc_nuoc/3.jpg
