BuiVanYen/DATN_START/Hardware/Sensor_use/muc_nuoc/4.jpg

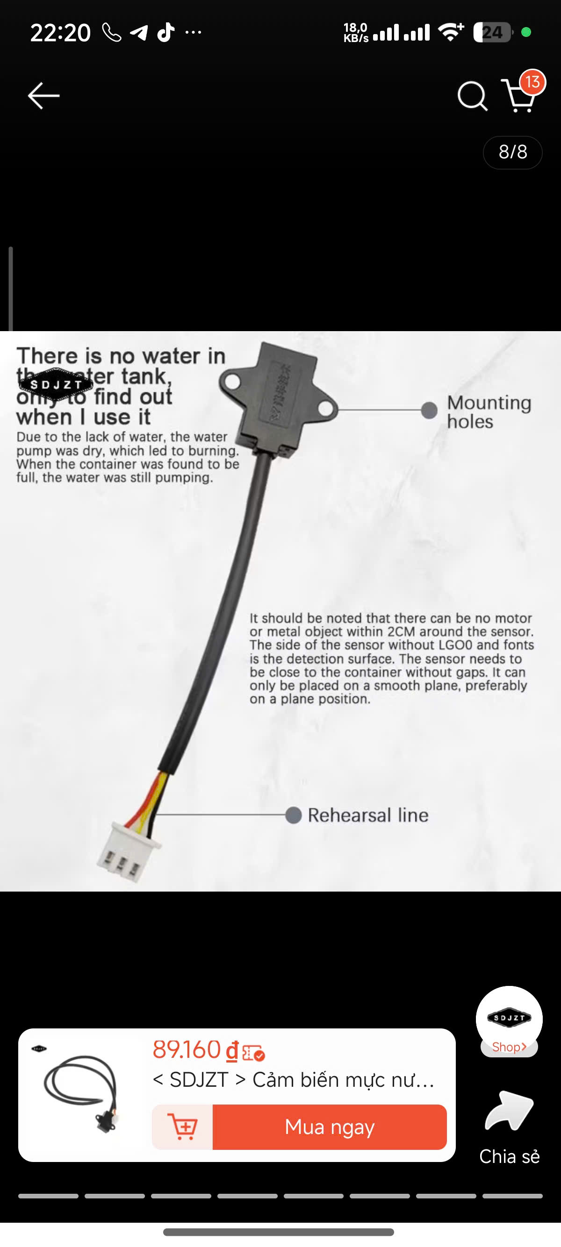
Hardware/Sensor_use/muc_nuoc/4.jpg
