BuiVanYen/DATN_START/Hardware/Sensor_use/muc_nuoc/image1.png

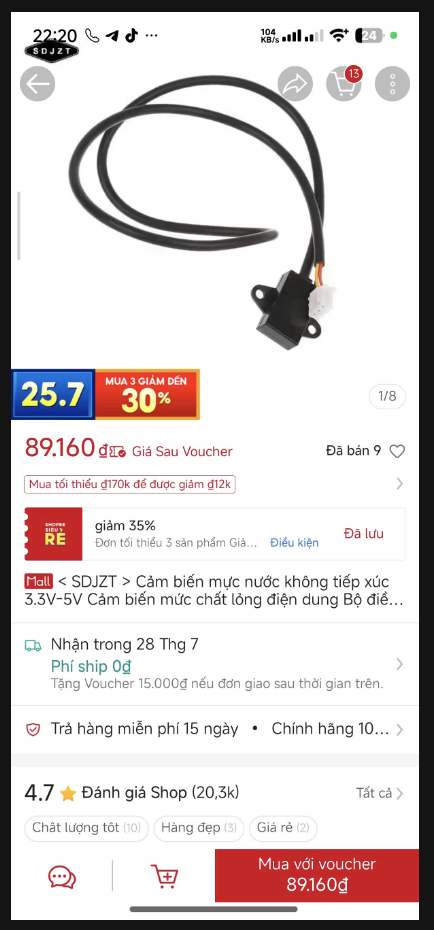
Hardware/Sensor_use/muc_nuoc/image1.png
