BuiVanYen/DATN_START/Hardware/Sensor_use/muc_nuoc/image2.png

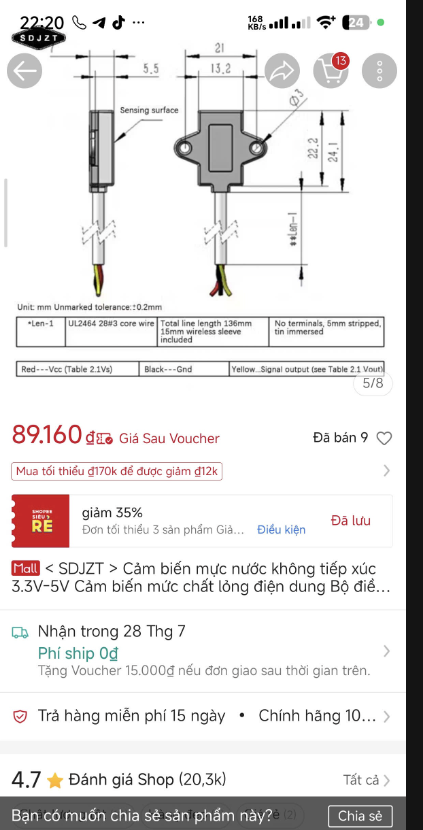
Hardware/Sensor_use/muc_nuoc/image2.png
