BuiVanYen/DATN_START/Hardware/Sensor_use/PH/image1.png

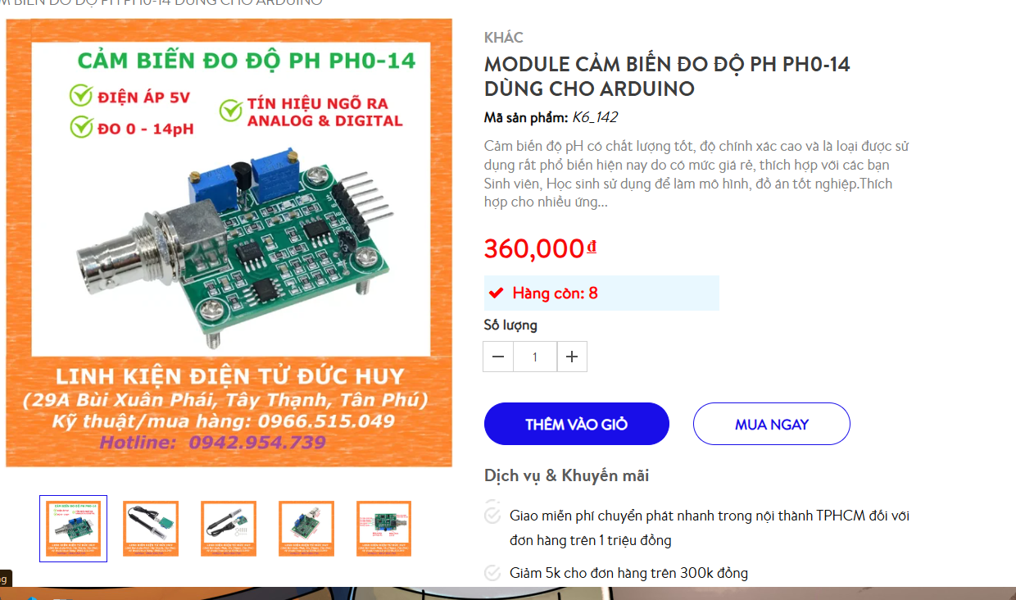
Hardware/Sensor_use/PH/image1.png
