BuiVanYen/DATN_START/Hardware/Sensor_use/PH/image2.png

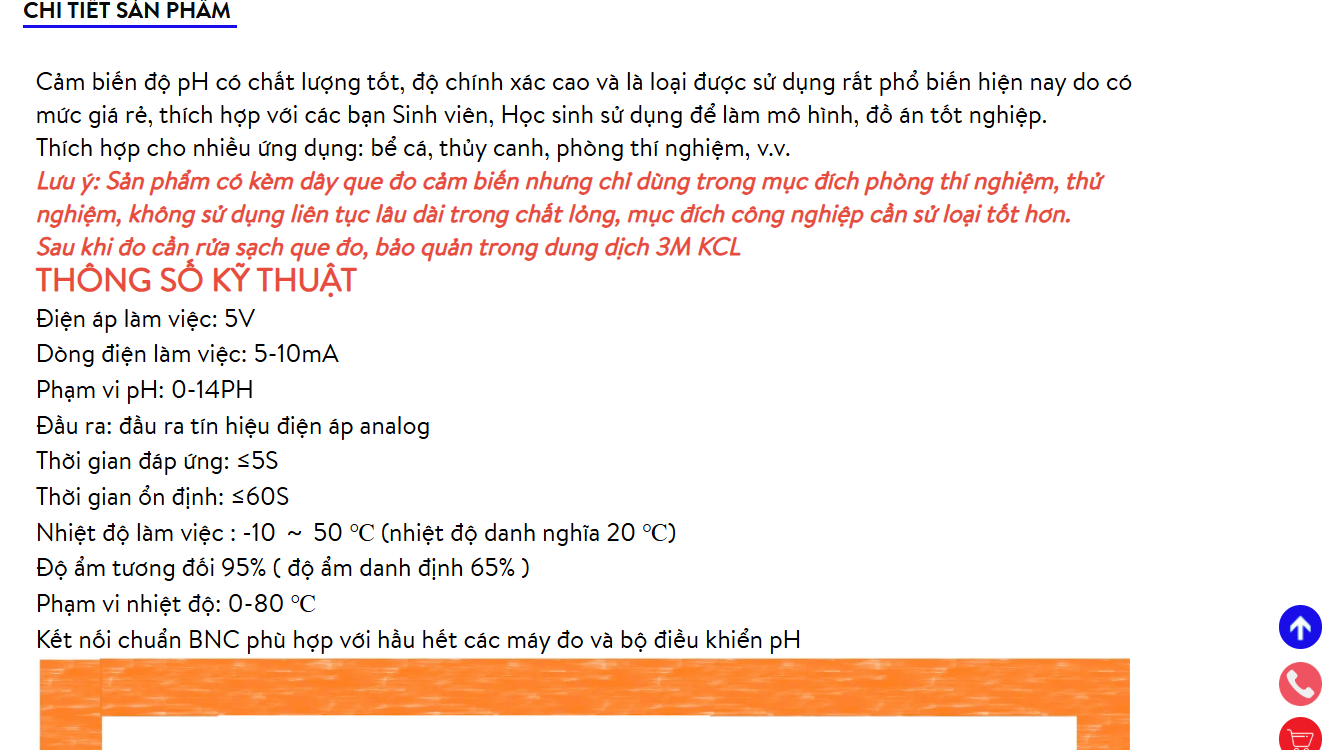
Hardware/Sensor_use/PH/image2.png
