BuiVanYen/DATN_START/Hardware/Sensor_use/sht30/image.png

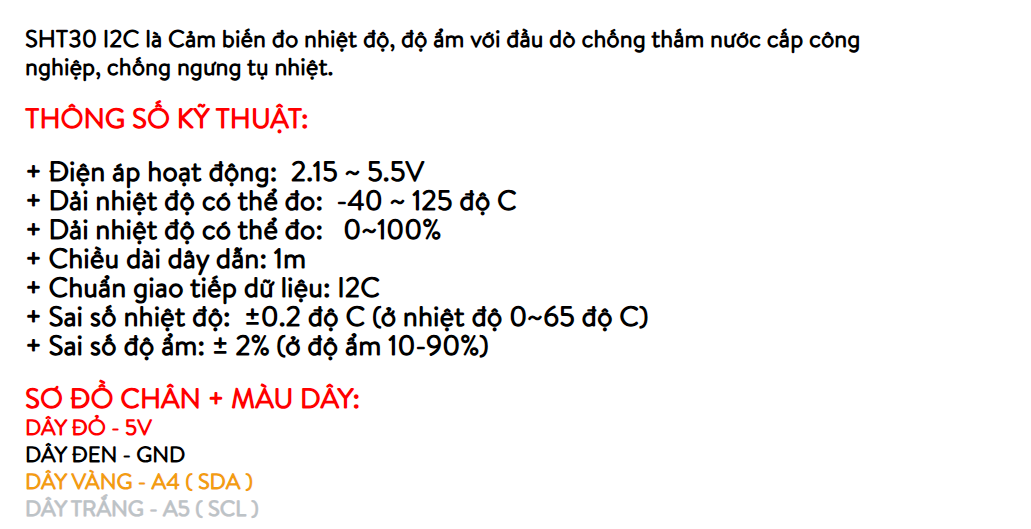
Hardware/Sensor_use/sht30/image.png
