BuiVanYen/DATN_START/Hardware/Sensor_use/TDS_DS18B20/image1.png

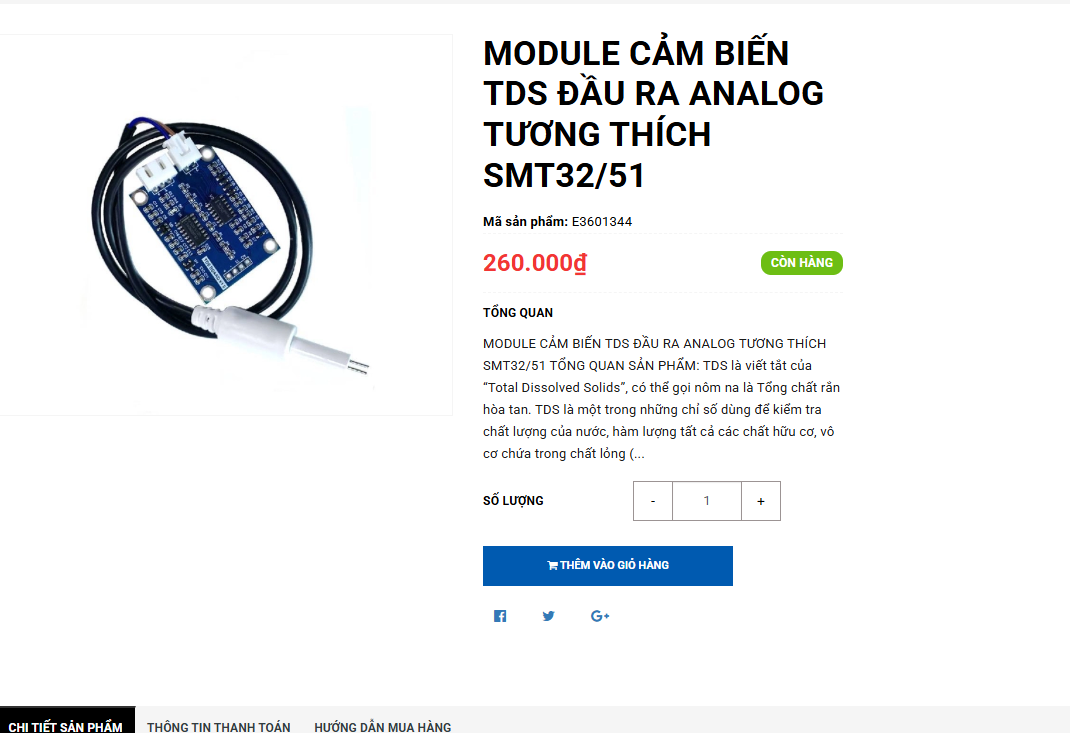
Hardware/Sensor_use/TDS_DS18B20/image1.png
