BuiVanYen/DATN_START/learning/photo/z7435084735842_a19f333dcdc927fca8d39e022870a6f5.jpg

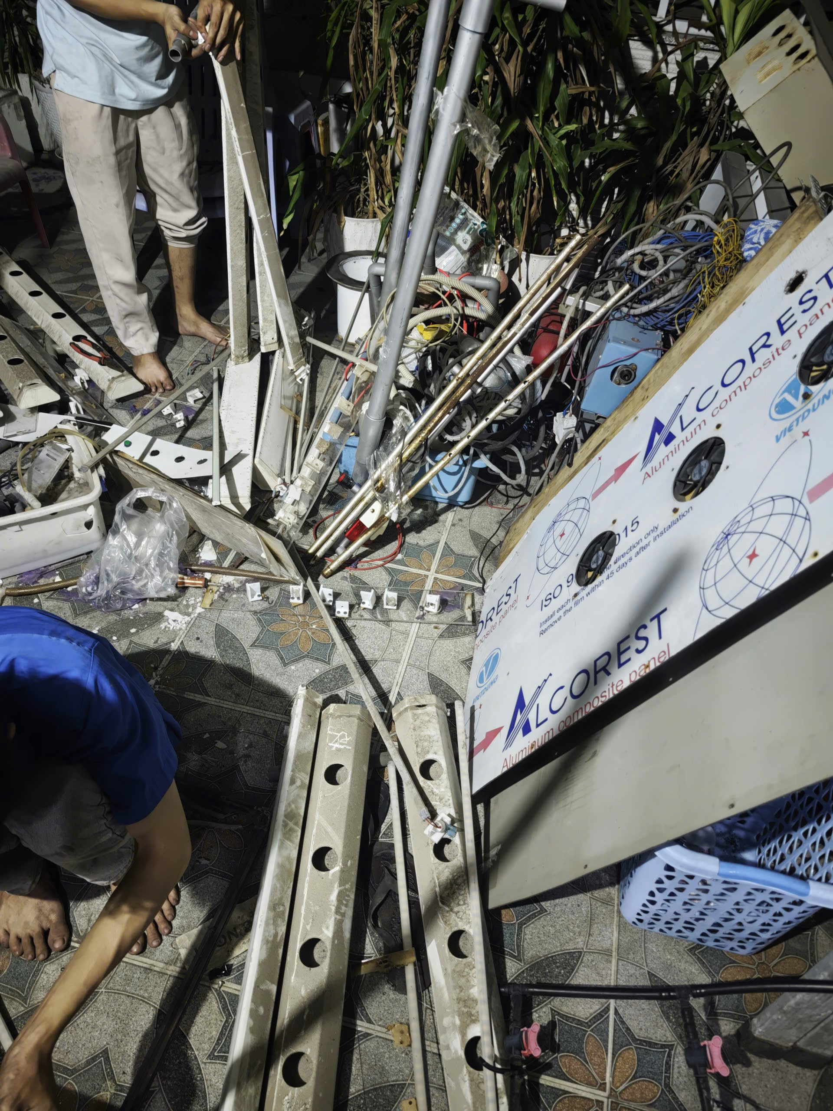
learning/photo/z7435084735842_a19f333dcdc927fca8d39e022870a6f5.jpg
