BuiVanYen/DATN_START/learning/photo/z7488489806235_9f2daaae7df4db6163e53d8fb15dda6e.jpg

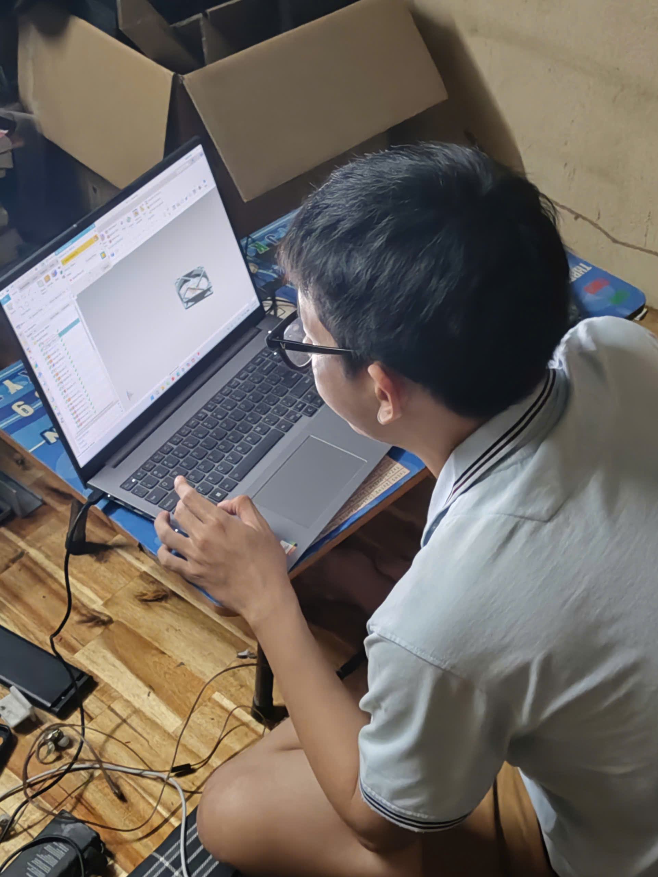
learning/photo/z7488489806235_9f2daaae7df4db6163e53d8fb15dda6e.jpg
