BuiVanYen/DATN_START/learning/photo/z7661221186275_e49a5c9b8552f25185a3cf834c34801d.jpg

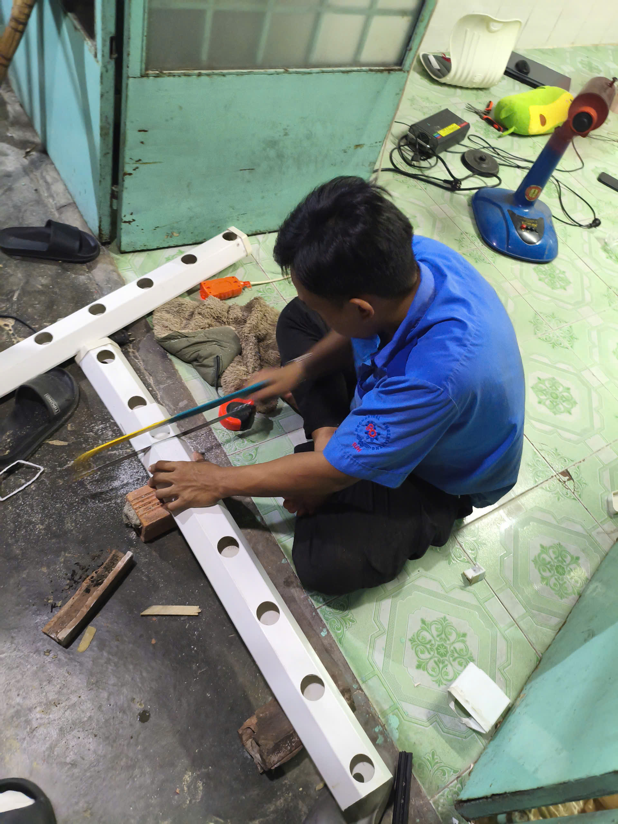
learning/photo/z7661221186275_e49a5c9b8552f25185a3cf834c34801d.jpg
