BuiVanYen/DATN_START/learning/photo/z7661221190547_020966b0c4cd59b24769fa0d180444f7.jpg

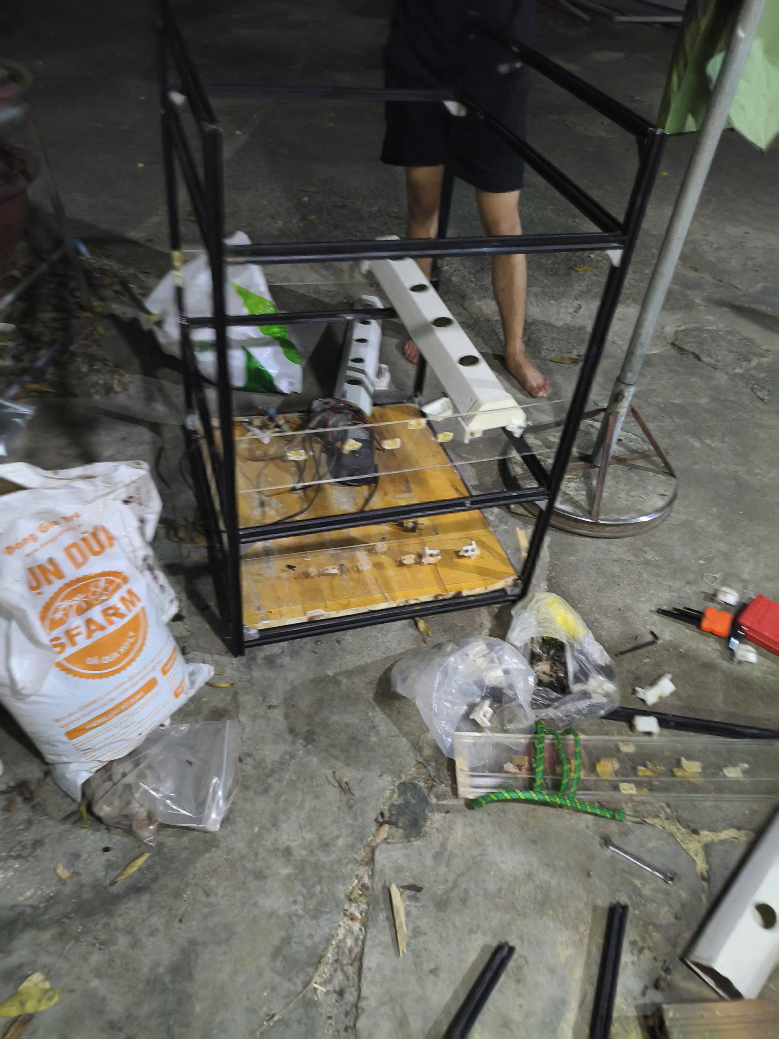
learning/photo/z7661221190547_020966b0c4cd59b24769fa0d180444f7.jpg
