BuiVanYen/DATN_START/learning/photo/z7921216067811_4c4755bf3b16a65b546c886cf1832613.jpg

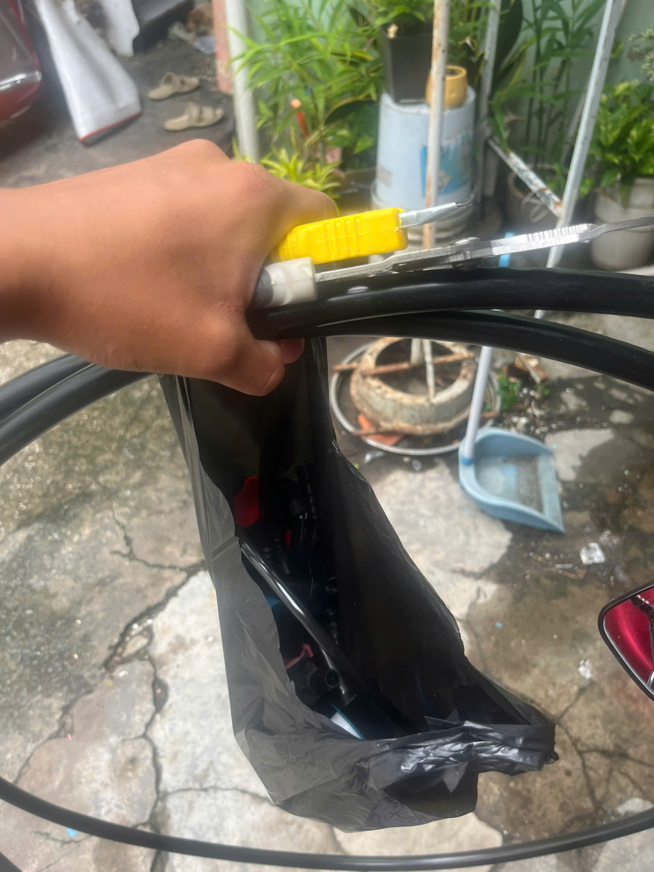
learning/photo/z7921216067811_4c4755bf3b16a65b546c886cf1832613.jpg
