BuiVanYen/DATN_START/learning/photo/z7931451199226_eea62bcc740c983f3ef4f381778db232.jpg

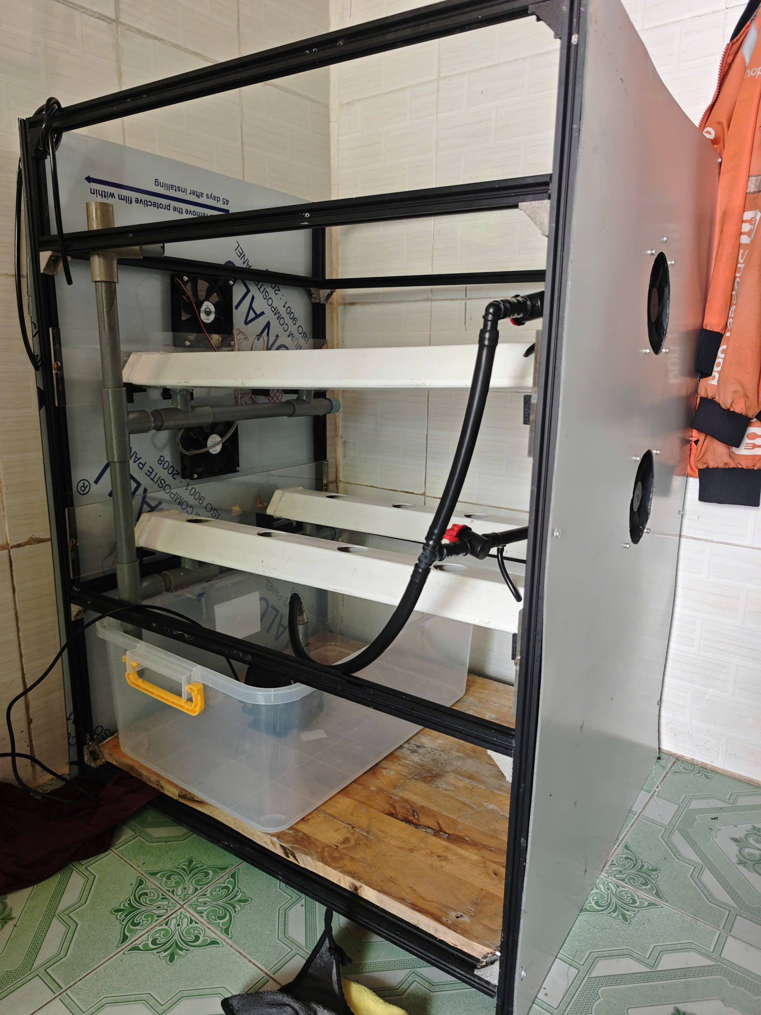
learning/photo/z7931451199226_eea62bcc740c983f3ef4f381778db232.jpg
