BuiVanYen/DATN_START/Hardware/PCB_Design/BOM_DATN-VER2_2026-06-19.csv

ID | Name | Designator | Footprint | Quantity | Manufacturer Part | Manufacturer | Supplier | Supplier Part | Price | CHỖ MUA | GIÁ | LINK | SL
1 | AMS1117-5.0 | AMS1117-3V3 | SOT-223 | 1 | AMS1117-5.0 | AMS | LCSC | C6187 | 0.231 | thegioiic | 4000 | https://www.thegioiic.com/ams1117-3-3v-ic-on-ap-3-3v-1a-sot-223 | 1
2 | DEVICE_BUZZER COPY | BZ1 | BUZZER_BEEPER:BUZZER_12X9.5RM7.6 | 1 |  |  |  |  |  | thegioiic | 4500 | https://www.thegioiic.com/1209-buzzer-coi-chip-12x9mm-93db-xuyen-lo | 1
3 | 22uF | C1 | CAP-SMD_BD6.3-L6.6-W6.6-LS7.2-FD | 1 | XT22UF50V90RV0083 | KNSCHA(科尼盛) | LCSC | C2992614 | 0.043 | thegioiic | 5000 | https://www.thegioiic.com/tu-nhom-smd-22uf-25v-5x5-4mm | 5
4 | 100nF | C2 | C0805 | 1 | FCC0805B104K101FT | FOJAN(富捷) | LCSC | C46635920 | 0.011 | thegioiic | 4340 | https://www.thegioiic.com/tu-gom-0805-100nf-0-1uf-50v | 20
5 | 100nF | C3 | C0805 | 1 | 0805B104K160CT-C | Walsin(华新科) | LCSC | C2991409 | 0.006
6 | 0.1uF | C4 | C0805 | 1 | 805 | null | LCSC | C9900012713
7 | 0.1uF 0805 | C5 | C0805 | 1 | 805 | null | LCSC | C9900012713
8 | 22uF | C14 | C0805 | 1 | 805 | null | LCSC | C9900012713 |  | thegioiic | 4500 | https://www.thegioiic.com/tu-gom-0805-22uf-16v | 5
9 | 1 mF | C6 | 1000UF/10V | 1 |  |  |  |  |  | thegioiic | 1100 | https://www.thegioiic.com/tu-hoa-1000uf-10v-8x12mm-xuyen-lo
10 | 104 | C7 | C0805 | 1 | TCC0805X7R104M101DT | CCTC(三环) | LCSC | C696890
11 | Bơm 220 | CN3 | SCREW TERMINAL 2PIN 5.08MM | 1 | 2 Pin Screw Terminal 5.08 | Phoenix Contact | Digi-Key | 277-5893-ND |  | SHOPPE | 9000 | https://shopee.vn/C%E1%BA%A7u-%C4%91%E1%BA%A5u-Domino-2EDG-5.08-Pluggable-Terminal-Block-5.08mm-2P-3P-4P-5P-6P-7P-8P-10P-12P-Header-c%E1%BA%AFm-r%C3%BAt-c%E1%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 | 2
12 | sục 220 | CN4 | SCREW TERMINAL 2PIN 5.08MM | 1 | 2 Pin Screw Terminal 5.08 | Phoenix Contact | Digi-Key | 277-5893-ND
13 | SS14 | D1,D2,D6,D7,D8,D9,D11,D13,D14,D15,D16,D17,D18 | SS14D DIODE SMD | 13 | 1N4007W | BLUE ROCKET | LCSC | C328592 | 0.01 | thegioiic | 7000 | https://www.thegioiic.com/ss14-sma-diode-schottky-1a-1n5819 | 20
14 | FR307 | D4,D5,D12 | M7 | 3 |  |  |  |  |  | thegioiic | 9000 | https://www.thegioiic.com/twgmc-1n4007-m7-sma-diode-chinh-luu-1a-1kv | 20
15 | đế cầu chì | F1 | FUSE-TH_L22.6-W9.0 | 1 | 5x20 BLX-A型 保险丝支架 XC-7 | xcfuse(旭程) | LCSC | C3131 | 0.079
16 | BOOT | H1 | HEADER-HEADER-FEMALE-2.54_1X2 | 1
17 | RELAY | K3,K4 | NINGBO SONGLE RELAY SRD-12VDC | 2 | SRD-12VDC-SL-A | Ningbo Songle Relay | LCSC | C93716 | 0.39 | TN | 14000 | https://dientutuyetnga.com/products/srd-12vdc-sl-a-relay-12v-10a-4-chan | 2
18 | 100uH | L3 | 100UH | 1 |  |  |  |  |  | thegioiic | 5000 | https://www.thegioiic.com/cuon-cam-dan-smd-cdrh127-1280-101-100uh-2-1a | 1
19 | LED SMD | LED2,LED4,LED5,LED6,LED7,LED8,LED9,LED10,LED12,LED13,LED15 | SM-LED-0805-RED | 11 |  |  |  |  |  | thegioiic | 5200 | https://www.thegioiic.com/led-xanh-la-0805-dan-smd-trong-suot | 20
20 | PWR | LED11 | PWR | 1
21 | AO3400A | Q9 | SOT-23-3_L2.9-W1.3-P1.90-LS2.4-BR | 1 | AO3400A | AOS | LCSC | C20917 | 0.085 | thegioiic | 3400 | https://www.thegioiic.com/ao3400a-mosfet-kenh-n-30v-5-7a-sot-23-3 | 1
22 | AO3401 - P-Channel | Q8 | AO3401 | 1 | AO3401 | Hottech | LCSC | C181091 | 0.037 | thegioiic | 3000 | https://www.thegioiic.com/ao3401a-mosfet-kenh-p-30v-4a-sot23 | 1
23 | 2,2kΩ | R10,R30,R32,R35,R36,R39,R41,R42,R43,R45 | R0805 | 10 | RT0805FRE0710KL | YAGEO(国巨) | LCSC | C869153 | 0.019 | thegioiic | 4750 | https://www.thegioiic.com/dien-tro-2-2-kohm-0805-1- | 50
24 | 10kΩ | R40 | R0805 | 1 | RT0805FRE0710KL | YAGEO(国巨) | LCSC | C869153 | 0.019 | thegioiic | 4750 | https://www.thegioiic.com/dien-tro-10-kohm-0805-1- | 50
25 | 1k | R4 | R0805 | 1 |  |  |  |  |  | thegioiic | 4750 | https://www.thegioiic.com/dien-tro-1-kohm-0805-5- | 50
26 | 470uF | U1 | CAP-SMD_BD10.0-L10.3-W10.3-LS11.3-FD | 1 | RVT1E471M1010 470UF 25V | DMBJ(振宝佳) | LCSC | C970707 | 0.115 | thegioiic | 2280 | https://www.thegioiic.com/tu-nhom-smd-470uf-25v-10x10-5mm | 1
27 | LM2596S-5.0/NOPB | U2 | TO-263-5_L10.2-W8.6-P1.70-LS14.4-BR | 1 | LM2596S-5.0/NOPB | TI(德州仪器) | LCSC | C116713 | 1.375 | thegioiic | 8000 | https://www.thegioiic.com/lm2596s-5-0-ic-dieu-chinh-giam-ap-5v-3a-to-263-5 | 1
28 | SS54 | U3,U16 | DO-214AB_L6.9-W5.9-LS7.9-RD | 2 | SS54 | Zhengxin(正芯) | LCSC | C19272197 |  | thegioiic | 11000 | https://www.thegioiic.com/ss54-sma-diode-shotky-5a-40v | 10
29 | KF7.62-2P | U15 | CONN-TH_KF7.62-2P | 1 | KF7.62-2P | KEFA(科发) | LCSC | C707824 | 0.125 | thegioiic | 2000 | https://www.thegioiic.com/kf7-62-2-terminal-khoi-han-pcb-2-cuc-20a-300v-7-62mm | 1
30 | 100nF | C8,C10,C9,C11,C12,C13,C15 | CAPACITOR 100NF SMD 0603 | 7 | C0603C104K5RACTU | KEMET(基美) | LCSC | C127833 | 0.06 | thegioiic | 4000 | https://www.thegioiic.com/tu-gom-0603-100nf-0-1uf-50v | 20
31 | 10kΩ | R16,R33,R19,R26,R3,R8,R13,R15,R20,R22,R25,R27,R38,R1,R5,R7,R9,R12,R14,R31,R44,R47,R49 | 0603_RESISTOR | 23 | 0603WAF1002T5E | UNI-ROYAL(厚声) | LCSC | C25804 | 0.001 | thegioiic | 3800 | https://www.thegioiic.com/dien-tro-10-kohm-0603-1- | 50
32 | 100kΩ | R17,R18 | 0603_RESISTOR | 2 | 0603WAF1002T5E | UNI-ROYAL(厚声) | LCSC | C25804 | 0.001 | thegioiic | 3800 | https://www.thegioiic.com/dien-tro-100-kohm-0603-1- | 50
33 | 1kΩ | R21,R28,R37,R48 | 0603_RESISTOR | 4 | 0603WAF1002T5E | UNI-ROYAL(厚声) | LCSC | C25804 | 0.001 | thegioiic | 3800 | https://www.thegioiic.com/dien-tro-1-kohm-0603-1- | 50
34 | 15kΩ | R24,R29,R2,R6,R11,R23 | 0603_RESISTOR | 6 | 0603WAF1002T5E | UNI-ROYAL(厚声) | LCSC | C25804 | 0.001 | thegioiic | 2950 | https://www.thegioiic.com/dien-tro-15-kohm-0603-5- | 50
35 | 100Ω | R34 | 0603_RESISTOR | 1 | 0603WAF1002T5E | UNI-ROYAL(厚声) | LCSC | C25804 | 0.001 | thegioiic | 3800 | https://www.thegioiic.com/dien-tro-100-ohm-0603-1- | 50
36 | ESP32-S3-WROOM-1-N8R8 | U4 | ESP32-S3-WROOM-1-N8A | 1 | ESP32-S3-WROOM-1-N8 | ESPRESSIF(乐鑫) | LCSC | C2913198 | 4.773 | TN | 125000 | https://dientutuyetnga.com/products/esp32-s3-wroom-1-n8r8-thu-phat-wifi-ble-esp32-8mb
37 | LEVEL1 | U13 | XH2.54 3-PIN | 1 | unknown | unknown |  | unknown |  |  | 6300 | https://www.thegioiic.com/dau-xh2-54mm-3-chan-thang-xuyen-lo | 20
38 | LEVEL4 | U12 | XH2.54 3-PIN | 1 | unknown | unknown |  | unknown
39 | LEVEL3 | U11 | XH2.54 3-PIN | 1 | unknown | unknown |  | unknown
40 | LEVEL2 | U9 | XH2.54 3-PIN | 1 | unknown | unknown |  | unknown
41 | IRLR7843 | Q1,Q2,Q3,Q4,Q5,Q6,Q7,Q10 | TO-252-3_L6.6-W6.1-P4.57-LS9.9-BR-CW | 8 | IRLR7843TRPBF-JSM | JSMSEMI(杰盛微) | LCSC | C18191948 | 0.341 |  | 27360 | https://www.thegioiic.com/irlr7843-mosfet-kenh-n-30v-161a-to-252-3 | 8
42 | HEADER - 2.54_1X2 | EN | HEADER-HEADER-FEMALE-2.54_1X2 | 1
43 | HEADER_4 PIN | UART | HEADER 4 | 1 |  |  | Sparkfun
44 | TDS_DS18 | TDS | HEADER4X1 | 1
45 | pH_Module | PH | HEADER4X1 | 1
46 | SHT31 | SHT | HEADER4X1 | 1
47 | BH1750 | U10 | HEADER4X1 | 1
48 | FLOW | U14 | XH2.54 3-PIN | 1 | unknown | unknown |  | unknown
49 | DEN1 | U17 | KF-3.81-6-V | 1
50 | BƠM LL3 | U18 | 3.81_2P | 1
51 | DEN2 | U19 | KF-3.81-6-V | 1
52 | PUMP12 | U20 | 3.81_2P | 1
53 | QUAT2 | U21 | KF-3.81-6-V | 1
54 | QUAT1 | U22 | KF-3.81-6-V | 1
55 | BOM LL1 | U23 | 3.81_2P | 1 |  |  |  |  |  |  | 39900 | https://shopee.vn/-5-C%C3%A1i-KF-3.81-2-R-Terminal-Block-Plug-in-H%C3%A0n-PCB-2-Ch%C3%A2n-Cong-3.81mm-300V-10A-Linh-Ki%E1%BB%87n-Smart-i.532992291.28436375646 | 5
56 | BOMLL2 | U24 | 3.81_2P | 1 |  |  |  |  |  |  | 27360 | https://www.thegioiic.com/kf-3-81-4-r-terminal-block-plug-in-han-pcb-4-chan-cong-3-81mm-300v-10a | 4
57 | C1815-SMD | U25,U26 | SOT23 SMD C1815 | 2 |  |  |  |  |  |  | 6840 | https://www.thegioiic.com/2sc1815-hf-transistor-npn-50v-0-15a-3-chan-sot-23 | 20
 |  |  |  |  |  |  |  |  |  |  | 371480
