BuiVanYen/DATN_START/Hardware/BanVeCK_Yen/BOM.png

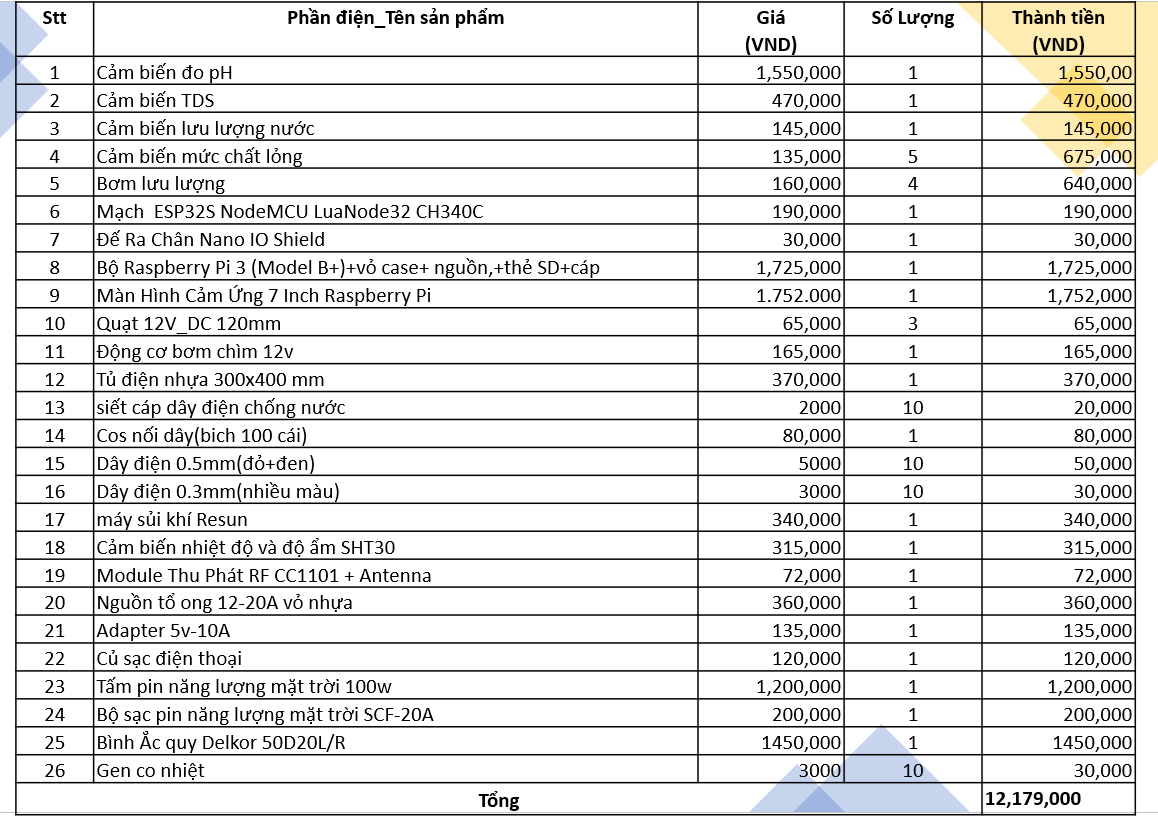
Hardware/BanVeCK_Yen/BOM.png
