BuiVanYen/DATN_START/(list of files, cad)

Other CAD files:
Hardware/BanVeCK_Yen/DeGo.prt
Hardware/BanVeCK_Yen/KHO_A3 _Test.prt
Hardware/BanVeCK_Yen/KHO_A3.prt
Hardware/BanVeCK_Yen/L.prt
Hardware/BanVeCK_Yen/LapRap.prt
Hardware/BanVeCK_Yen/RUOT.prt
Hardware/BanVeCK_Yen/alu.prt
Hardware/BanVeCK_Yen/fancase.prt
Hardware/BanVeCK_Yen/hopnhuatrongcay.prt
Hardware/BanVeCK_Yen/kedomang(left).prt
Hardware/BanVeCK_Yen/kedomang(right).prt
Hardware/BanVeCK_Yen/kegoc.prt
Hardware/BanVeCK_Yen/mica61.5x20.prt
Hardware/BanVeCK_Yen/mica63.5x11(Fix).prt
Hardware/BanVeCK_Yen/nhom100.prt
Hardware/BanVeCK_Yen/nhom60cm.prt
Hardware/BanVeCK_Yen/nhom72cm.prt
Hardware/BanVeCK_Yen/octan.prt
Hardware/BanVeCK_Yen/quattannhiet.prt
