BuiVanYen/DATN_START/Hardware/PCB_Design/Schematic_DATN-VER2_2026-06-19.pdf

# KH I NGU N

# KH I RELAY

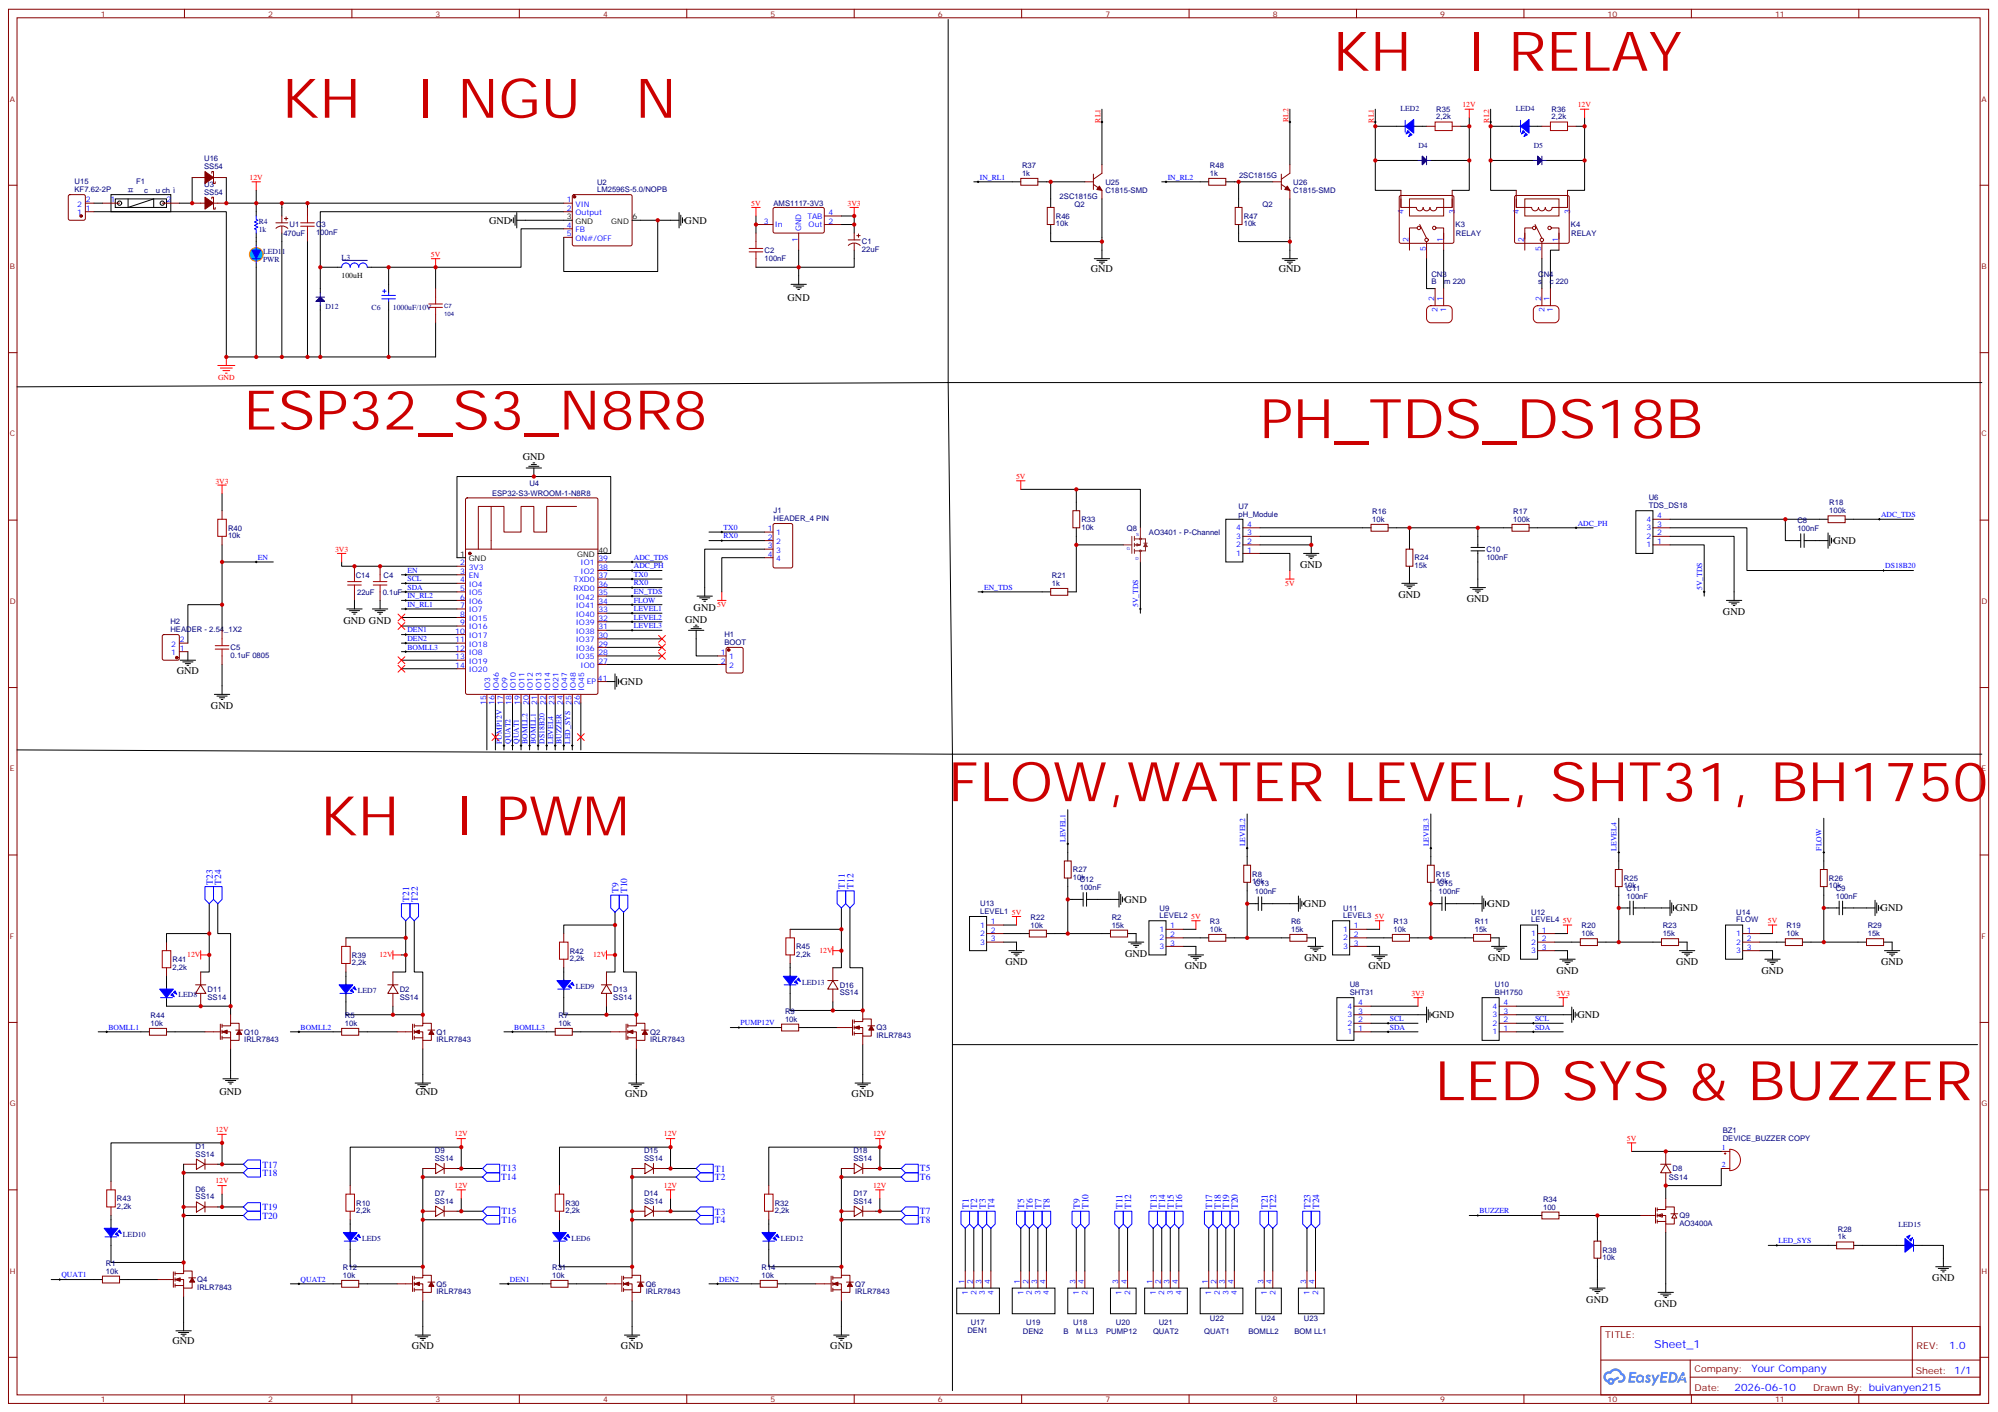
[picture p72: page 1]
