BuiVanYen/DATN_START/(commit log)

2026-07-10 hoan thanh file actuator, sua ota, nang cap dashboard 11 cam bien va 10 thiet bi dieu khien
2026-07-10 khac phuc loi delay va treo web bang cach set timeout I2C va cache gia tri cam bien de tranh block websocket
2026-07-10 bo het nhan GPIO va reorder thiet bi ngoai vi theo thu tu yeu cau
2026-07-10 tich hop nen Gzip truoc (pre-compressed Gzip) cho giao dien web de toi uu toc do load
2026-07-10 tổng kết 10/7/2026, xong điều khiển ngoại vi, bh1750 web ổn
2026-07-13 chore: upgrade configuration to ESP32-S3 N16R8 flash config, update sensors and clean up docs
2026-07-20 refactor(firmware): xóa biểu đồ khỏi giao diện local
2026-07-20 feat(firmware): tich hop driver cam bien tu firmware_Thinh
2026-07-23 xong manual, lỗi thoát web ngoại vi tự tắt mà ko có timeout
2026-07-23 docs: cap nhat thong so thuc nghiem bom 12V 200ml/130s va dung dich AB ph down vao file ke hoach
